ripolab/Placas-PCB/Saba-TIC 2018/Documentacion/es/guia soldadura.pptx

Taller de Soldadura Electrónica Familiar

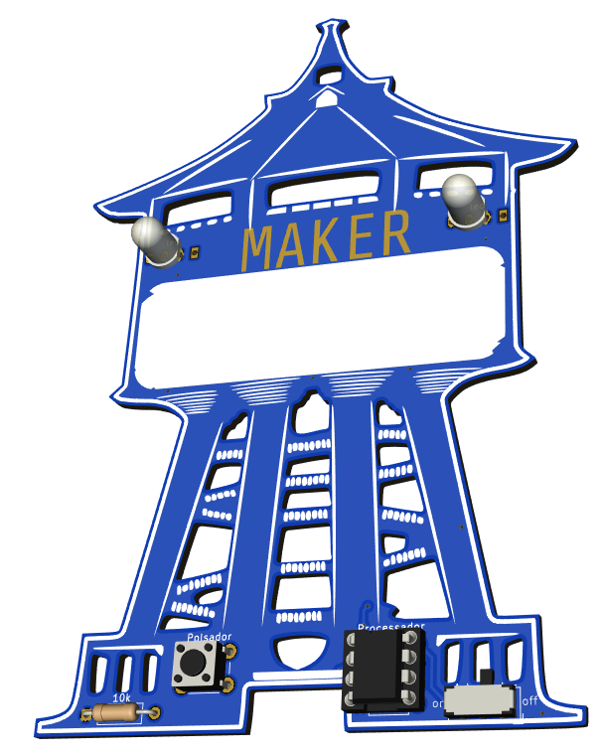
[picture p3: figure]

## Slide 2

Circuito espagueti
Un pulsador y un led

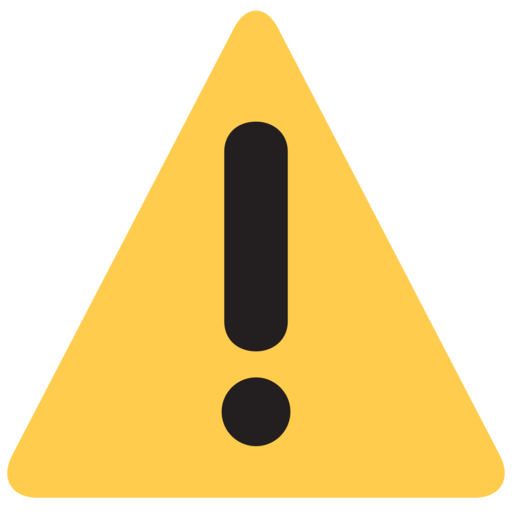
[picture p4: figure]

Rojo “+” / Negro “-”

Los leds tienen una pata “+” y “-” ¿Cual?

Mira cómo están conectados por dentro estos componentes

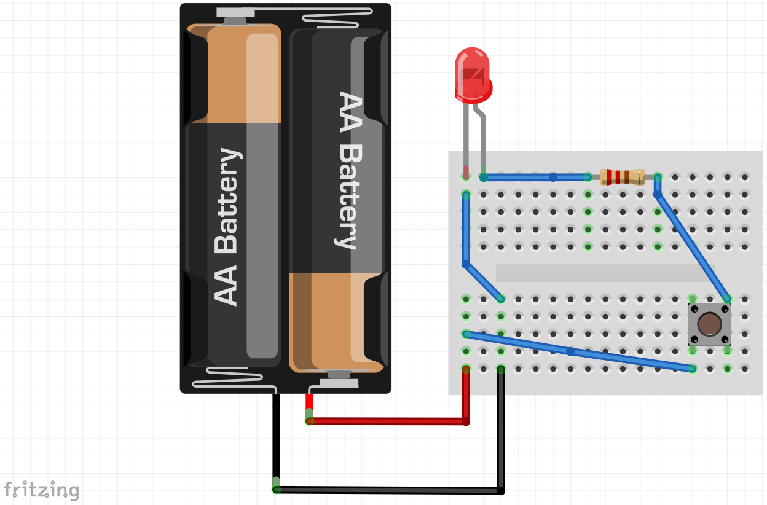
[picture p5: figure]
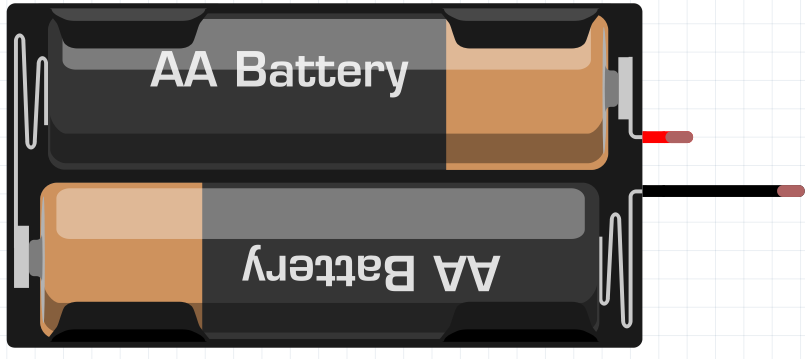
[picture p6: figure]
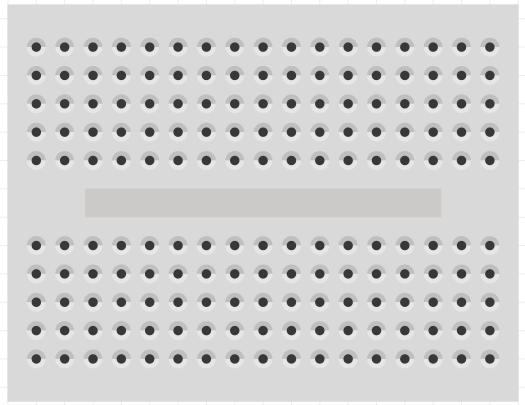
[picture p7: figure]

## Slide 3

Fabricación Digital

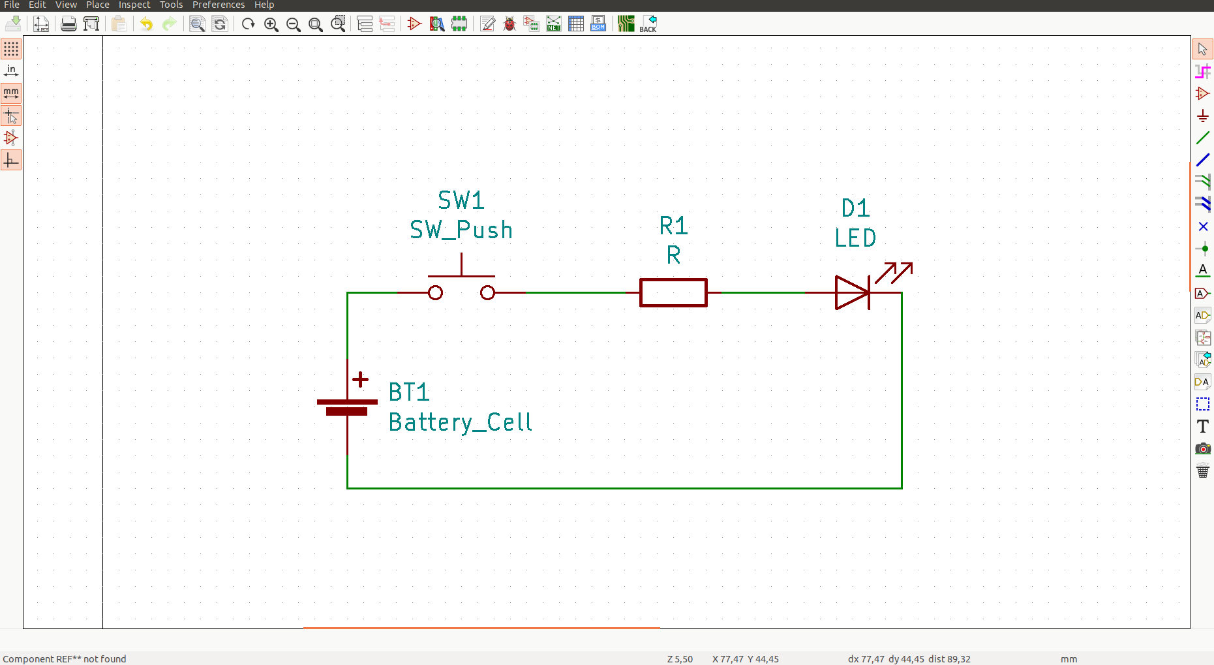
[picture p8: figure]

## Slide 4

Fabricación Digital

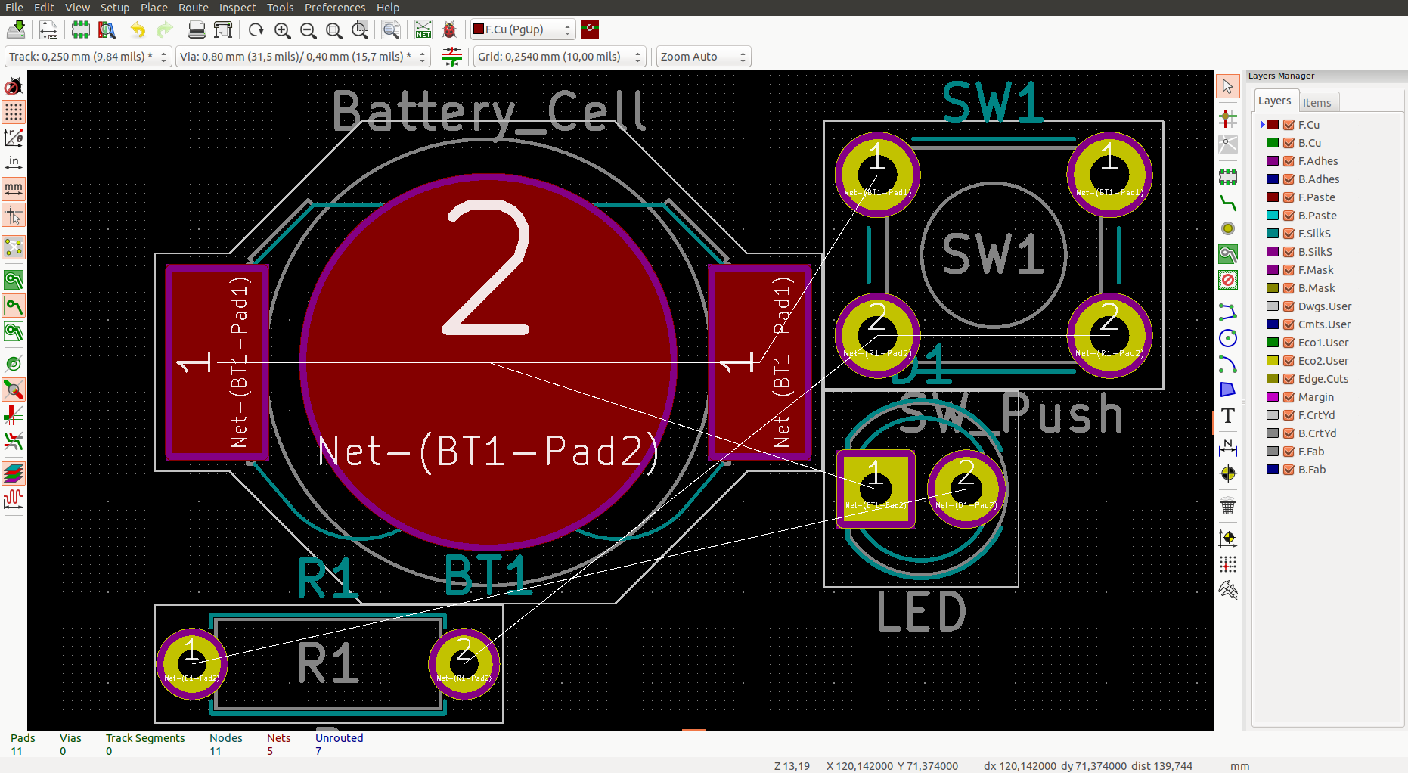
[picture p9: figure]

## Slide 5

Fabricación Digital

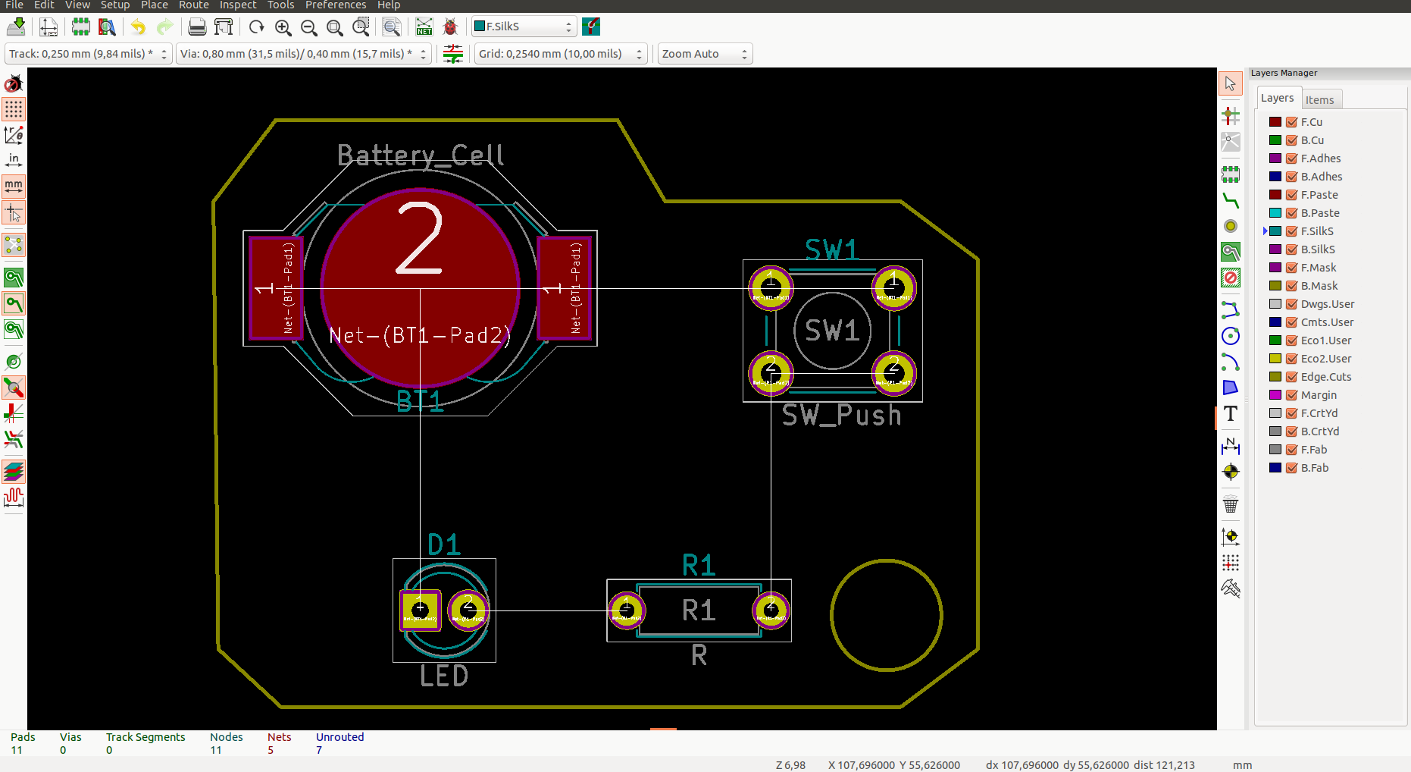
[picture p10: figure]

## Slide 6

Fabricación Digital

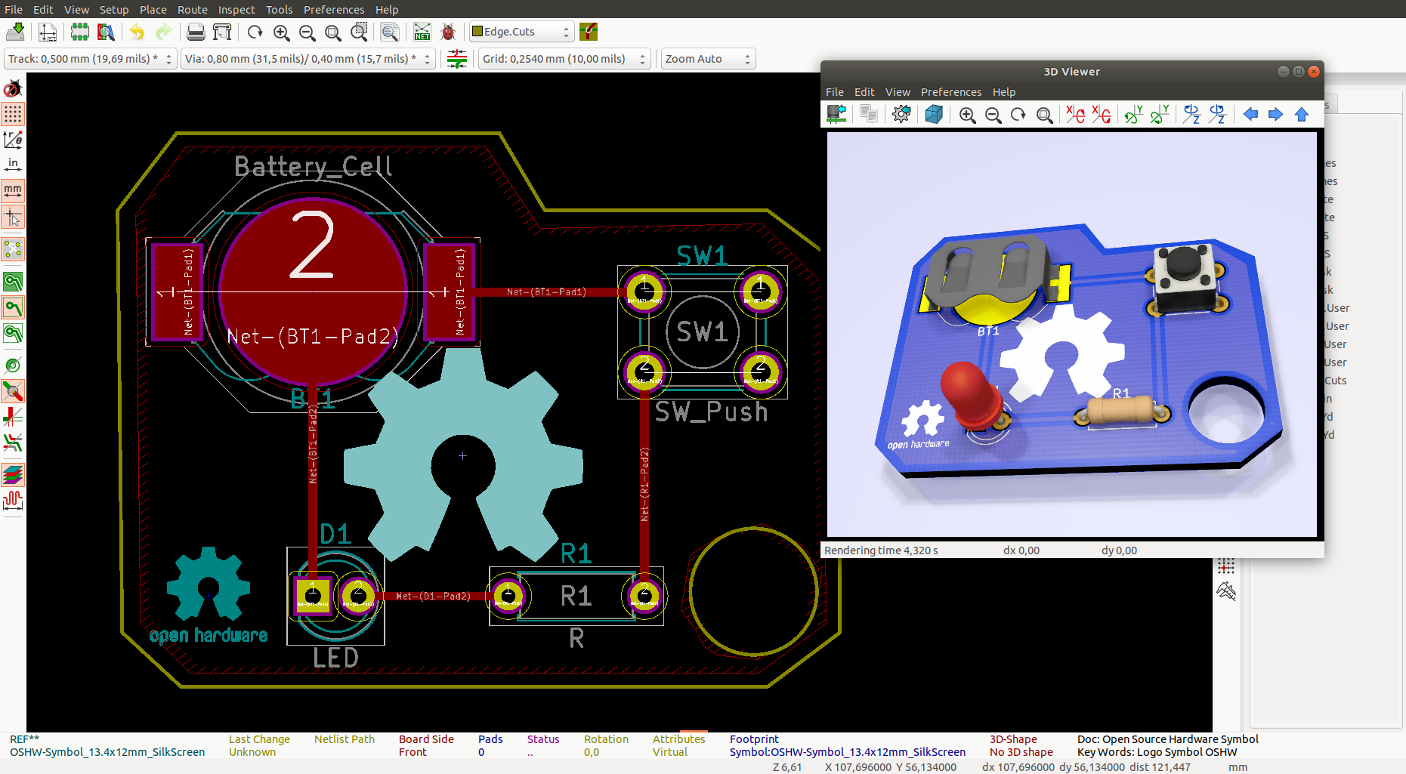
[picture p11: figure]

## Slide 7

¿Cómo utilizar el soldador?

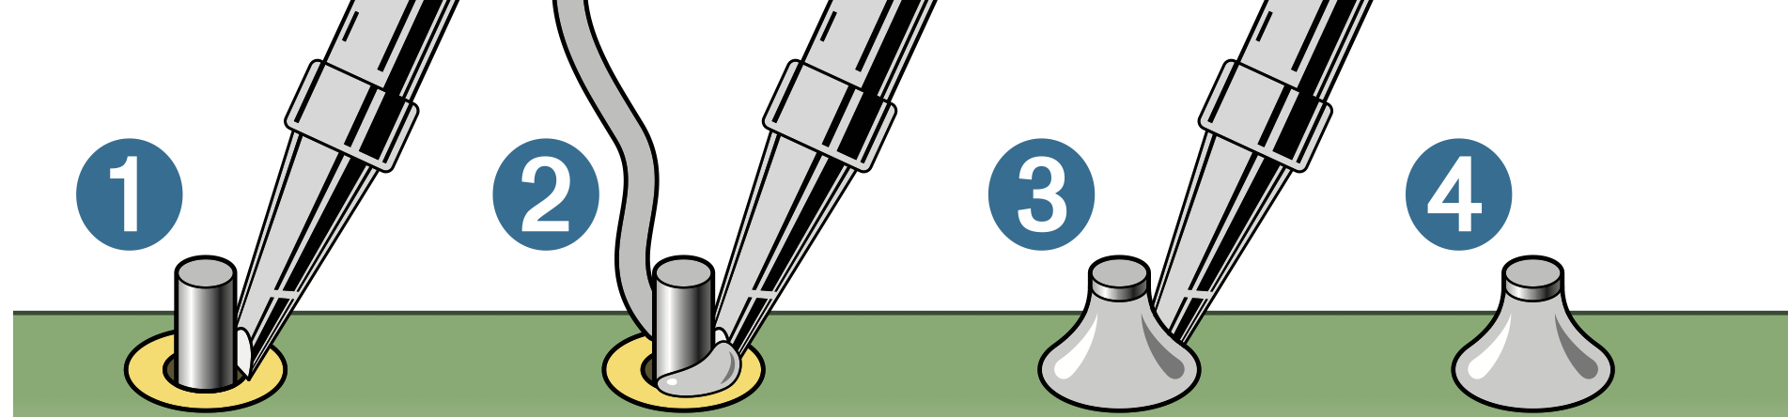
[picture p12: figure]

Calienta el componente y la base 2-3seg

Ponemos un poco de estaño

Retira el estaño y continua calentando 1-2seg

Perfecto!!!

GUIA DE SOLDADURA

Limpia simpre la punta del solddor antes de utilizarlo con un nuevo componente.

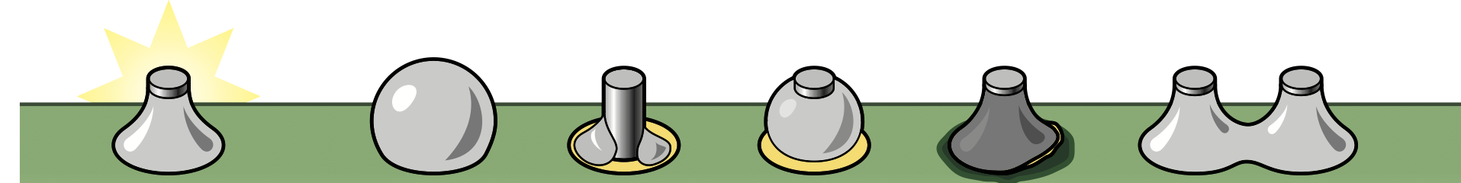
[picture p13: figure]
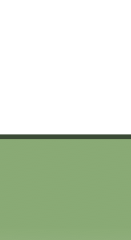
[picture p14: figure]
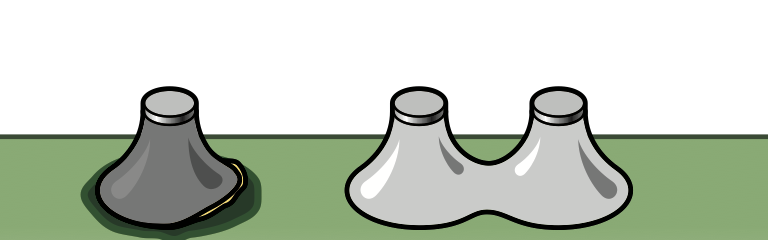
[picture p15: figure]

Cortocircuito

Perfecto

Mucho estaño

Poco estaño

Soldadura fría

Mucho calor

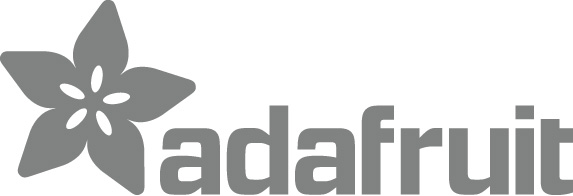
[picture p16: figure]
