ripolab/Placas-PCB/recursos/path4149.png

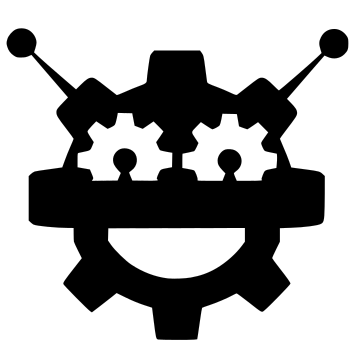
recursos/path4149.png
