ripolab/Placas-PCB/ripolab_pcb/imagenes/configuracion IDE Arduino.png

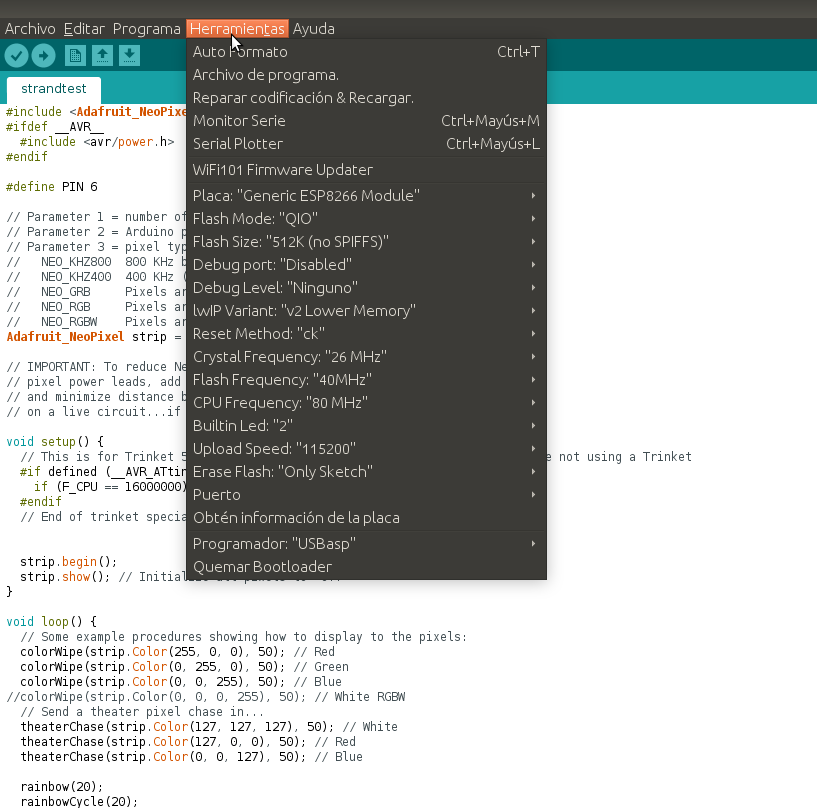
ripolab_pcb/imagenes/configuracion IDE Arduino.png
