ripolab/Placas-PCB/ripolab_pcb/imagenes/ripolab_pcb_back.jpg

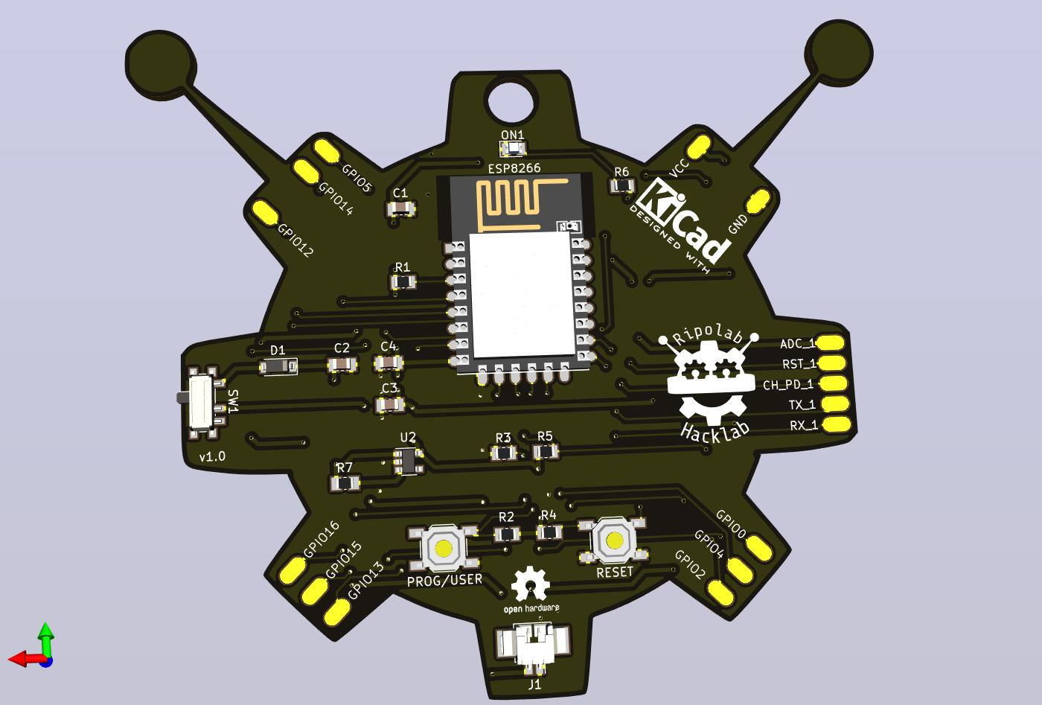
ripolab_pcb/imagenes/ripolab_pcb_back.jpg
