ripolab/Placas-PCB/ripolab_pcb/imagenes/ripolab_pcb_back_v2.jpg

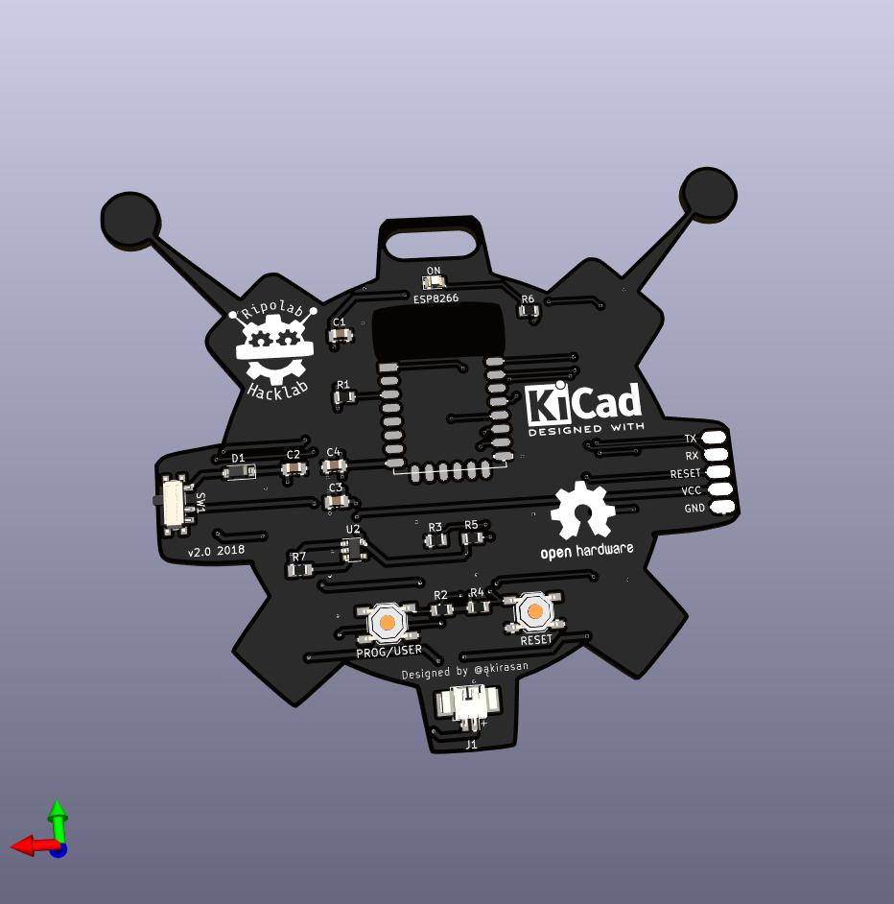
ripolab_pcb/imagenes/ripolab_pcb_back_v2.jpg
