ripolab/Placas-PCB/ripolab_pcb/imagenes/ripolab_pcb_final_back.jpg

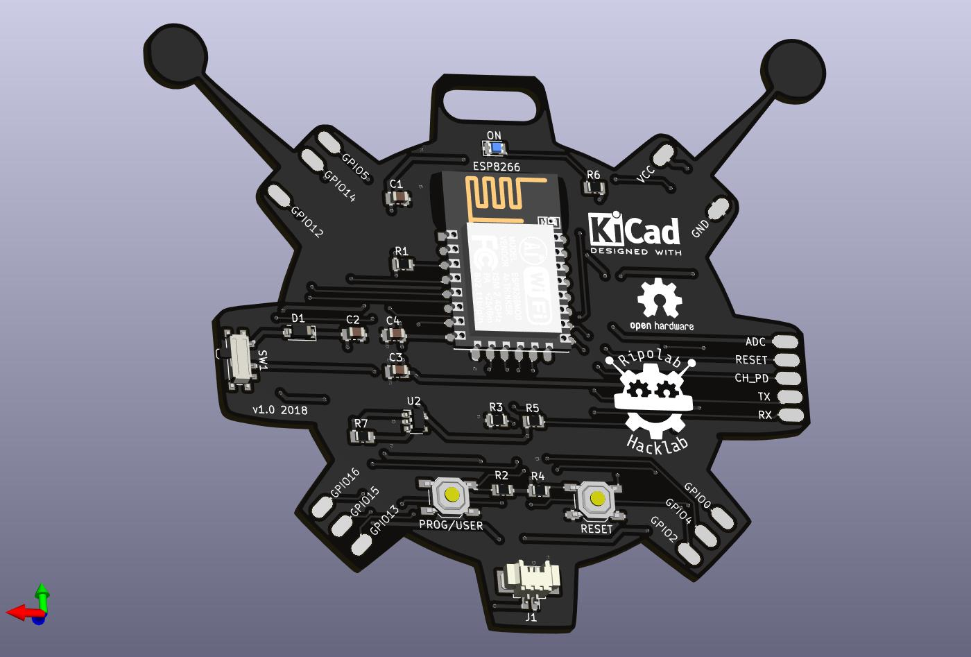
ripolab_pcb/imagenes/ripolab_pcb_final_back.jpg
