ripolab/Placas-PCB/ripolab_pcb/imagenes/ripolab_pcb_final_front.jpg

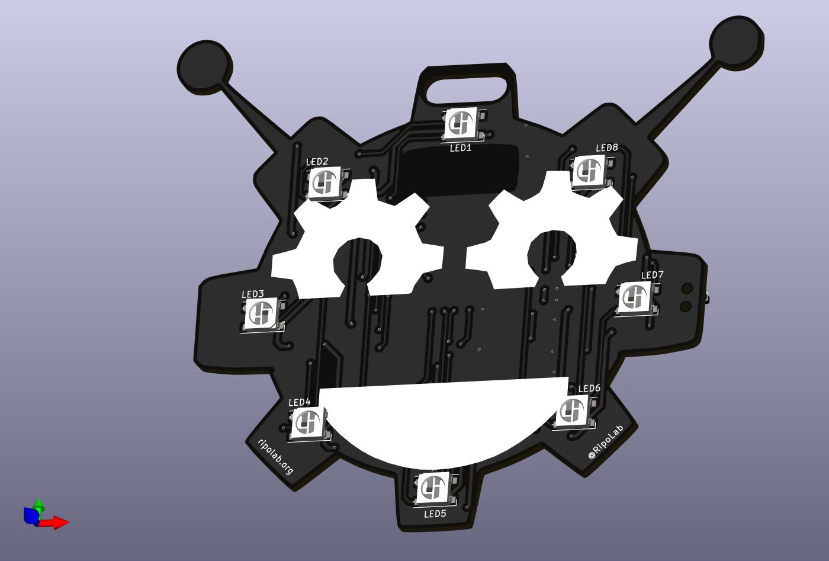
ripolab_pcb/imagenes/ripolab_pcb_final_front.jpg
