ripolab/Placas-PCB/ripolab_pcb/imagenes/ripolab_pcb_front1.jpg

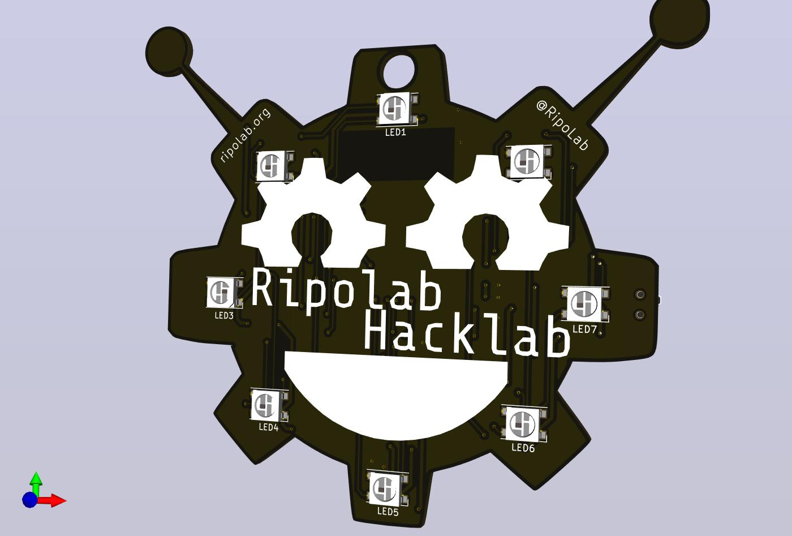
ripolab_pcb/imagenes/ripolab_pcb_front1.jpg
