ripolab/Placas-PCB/ripolab_pcb/imagenes/ripolab_pcb_front3.jpg

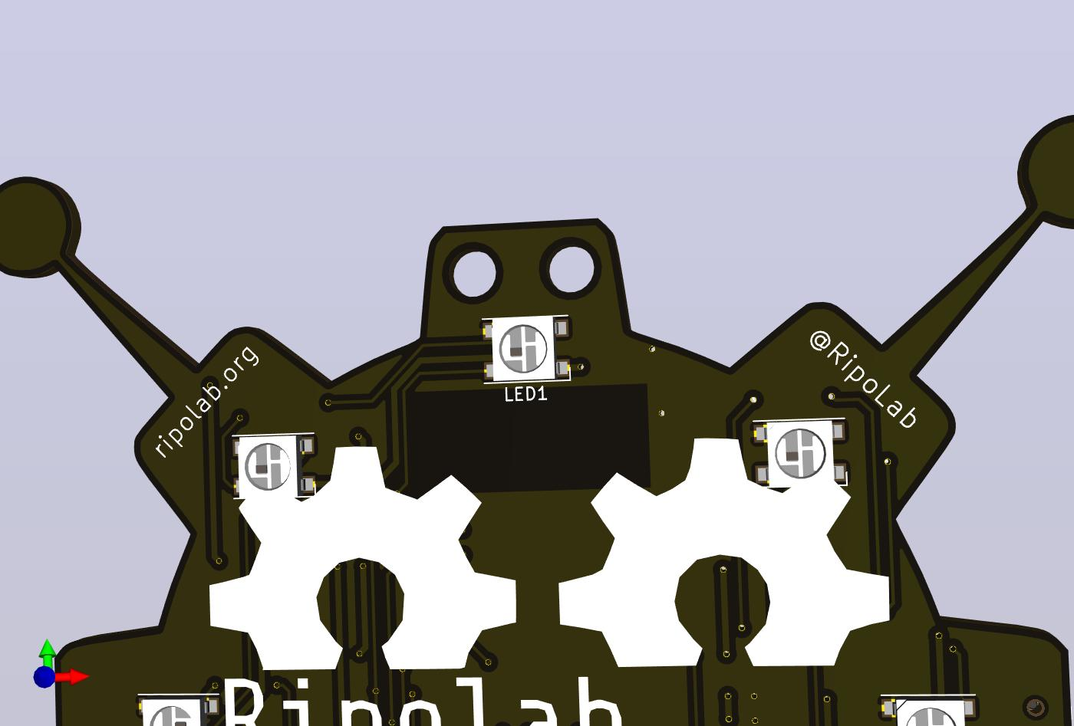
ripolab_pcb/imagenes/ripolab_pcb_front3.jpg
