ripolab/Placas-PCB/ripolab_pcb/imagenes/ripolab_pcb_front4.jpg

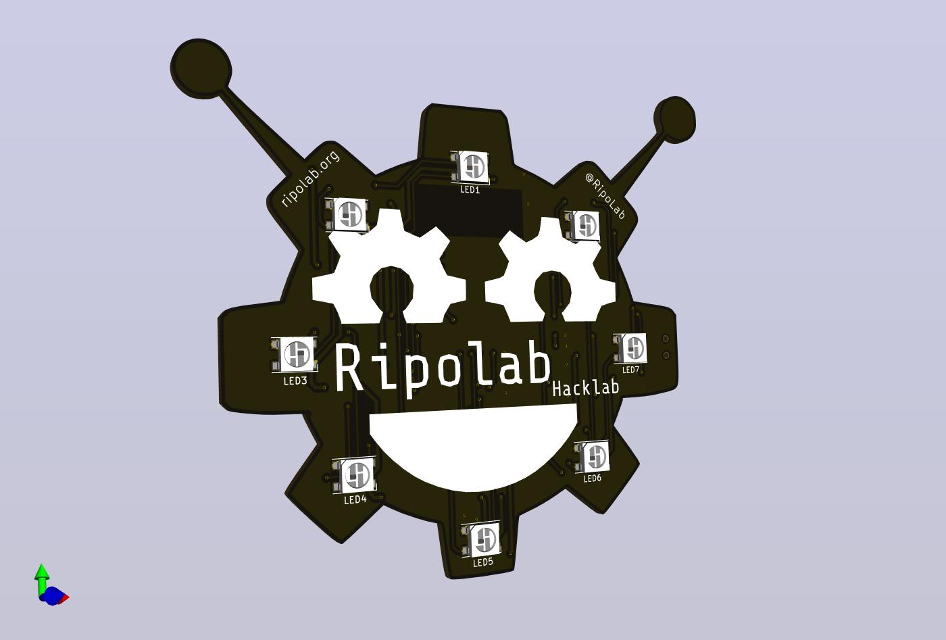
ripolab_pcb/imagenes/ripolab_pcb_front4.jpg
