ripolab/Placas-PCB/ripolab_pcb/imagenes/ripolab_pcb_front5.jpg

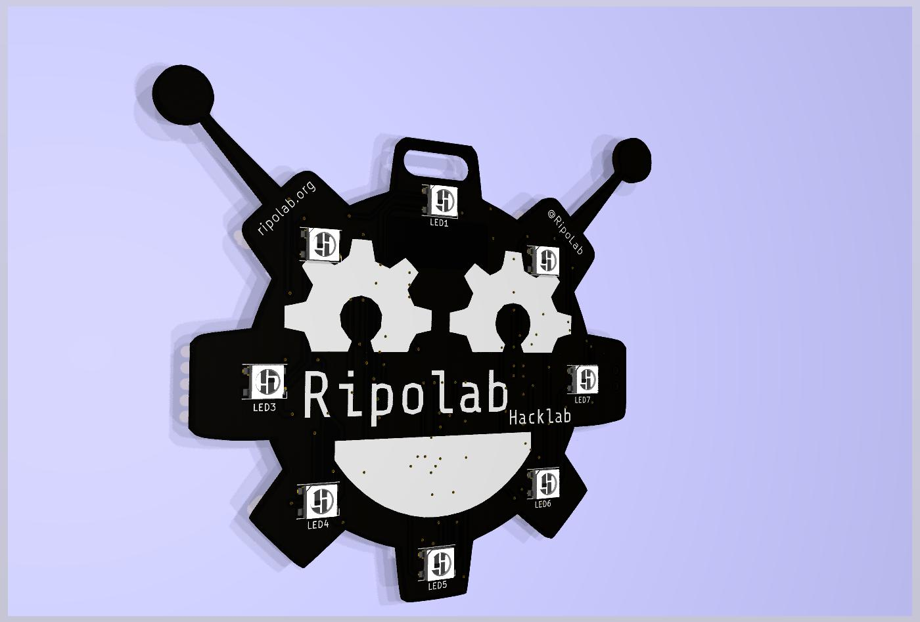
ripolab_pcb/imagenes/ripolab_pcb_front5.jpg
