ripolab/Placas-PCB/ripolab_pcb/imagenes/ripolab_pcb_front6.jpg

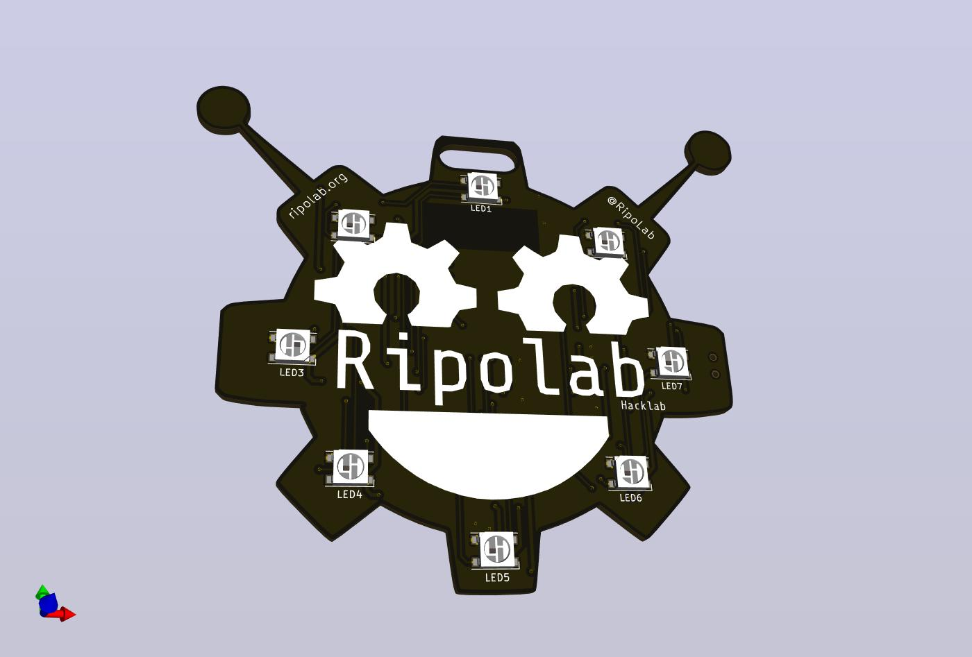
ripolab_pcb/imagenes/ripolab_pcb_front6.jpg
