ripolab/Placas-PCB/ripolab_pcb/imagenes/ripolab_pcb_front7.jpg

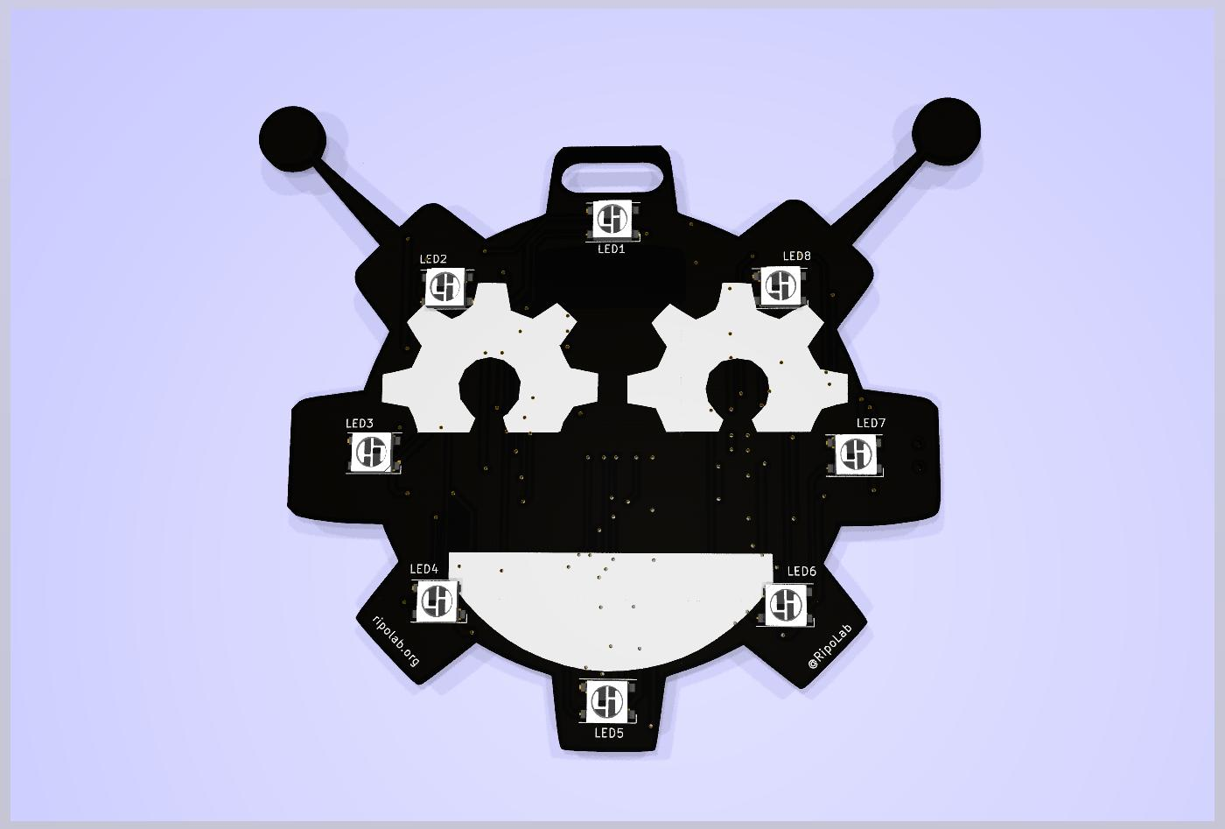
ripolab_pcb/imagenes/ripolab_pcb_front7.jpg
