ripolab/Placas-PCB/ripolab_pcb/imagenes/ripolab_pcb_front_v2.jpg

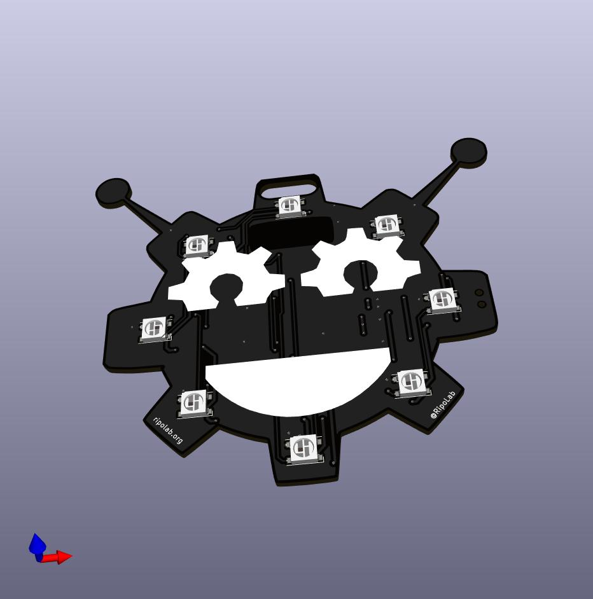
ripolab_pcb/imagenes/ripolab_pcb_front_v2.jpg
