ripolab/Placas-PCB/ripolab_protoboard/imagenes/ripolab_protroboard_v2_i2.png

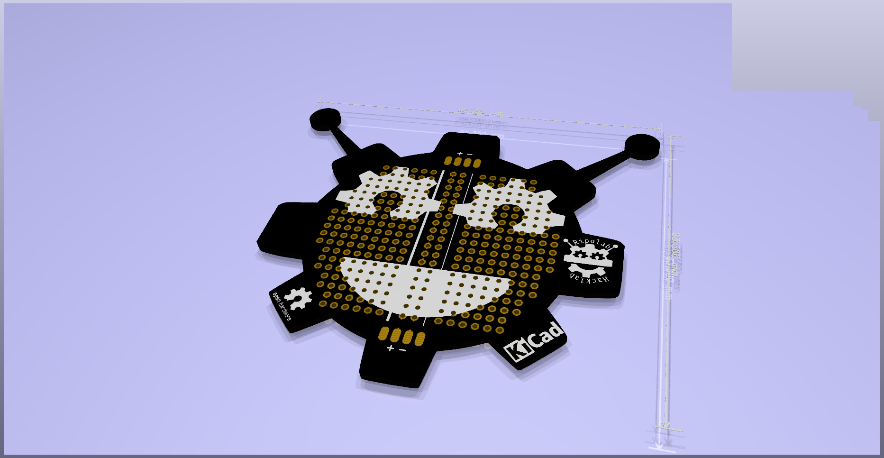
ripolab_protoboard/imagenes/ripolab_protroboard_v2_i2.png
