ripolab/Placas-PCB/ripolab_protoboard/imagenes/ripolab_protroboard_v2_i3.png

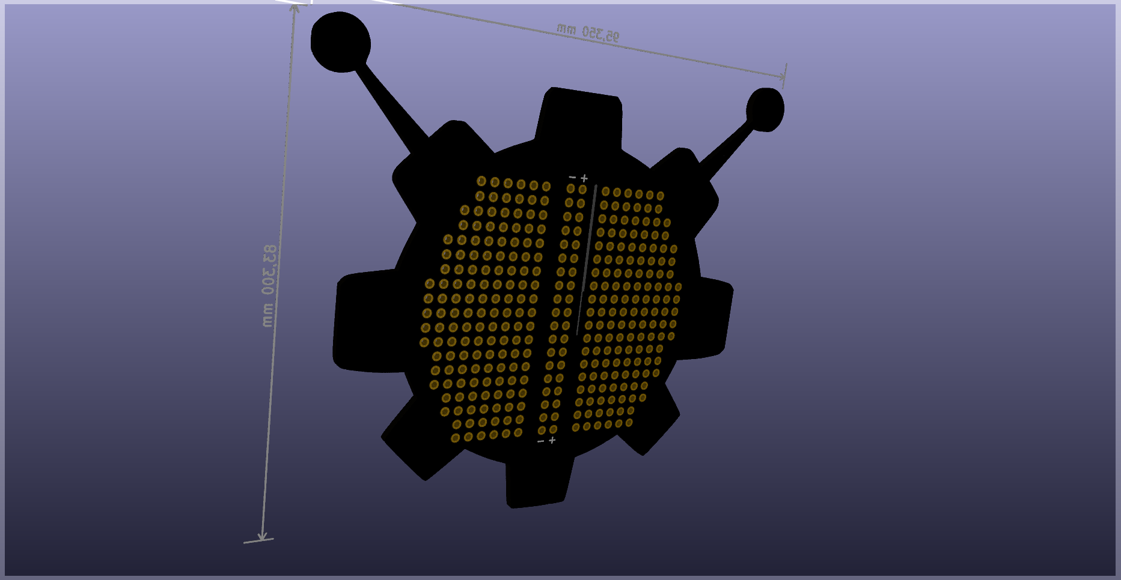
ripolab_protoboard/imagenes/ripolab_protroboard_v2_i3.png
