ripolab/Placas-PCB/ROBOTAC 19/diseño/proto1.jpg

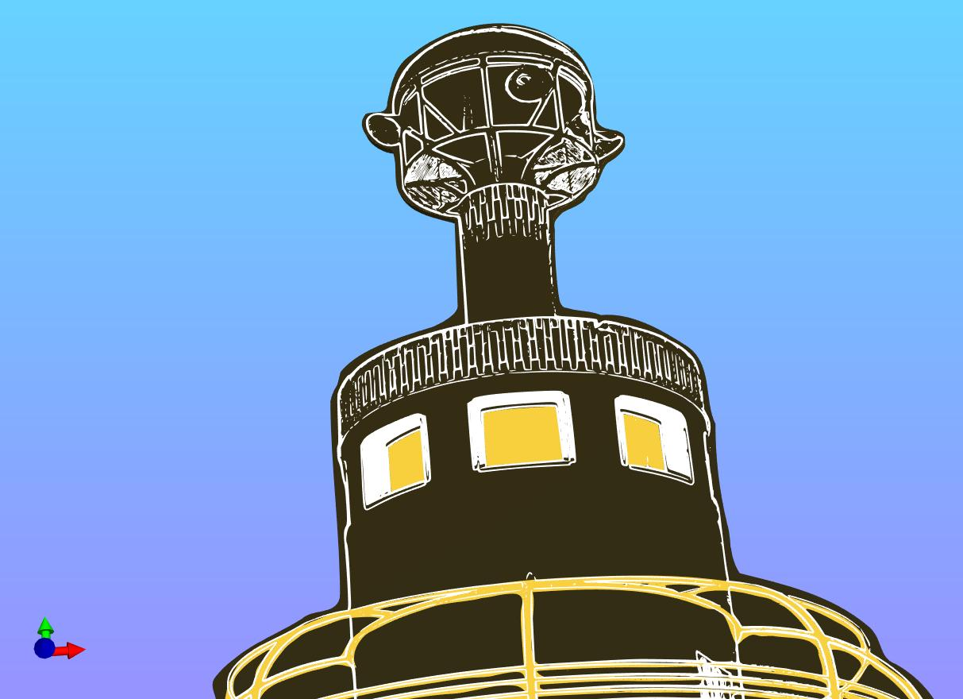
ROBOTAC 19/diseño/proto1.jpg
