ripolab/Placas-PCB/ROBOTAC 19/diseño/proto1.png

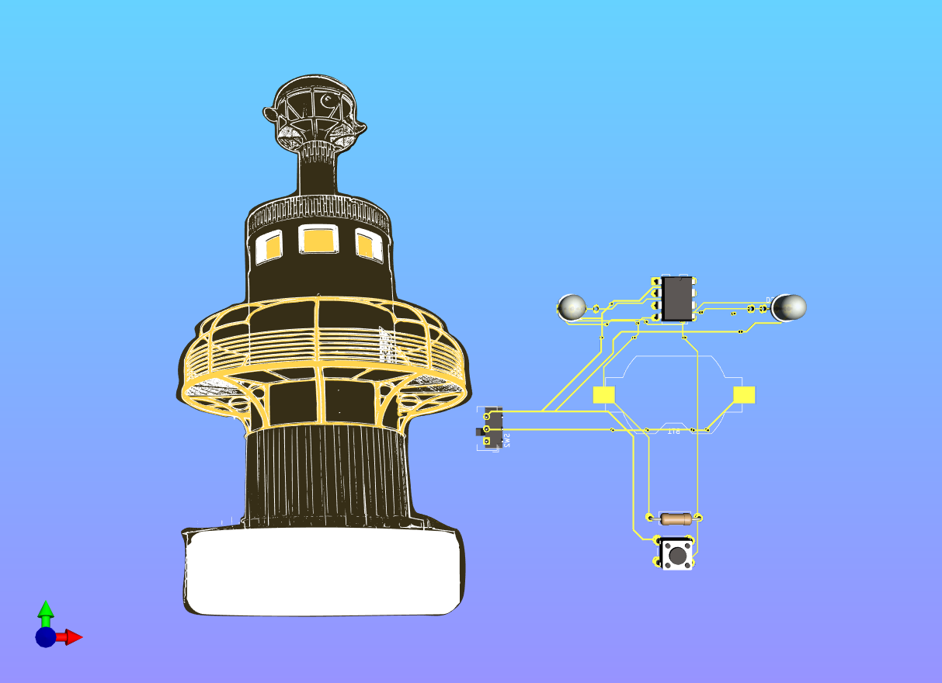
ROBOTAC 19/diseño/proto1.png
