ripolab/Placas-PCB/ROBOTAC 19/diseño/proto2.jpg

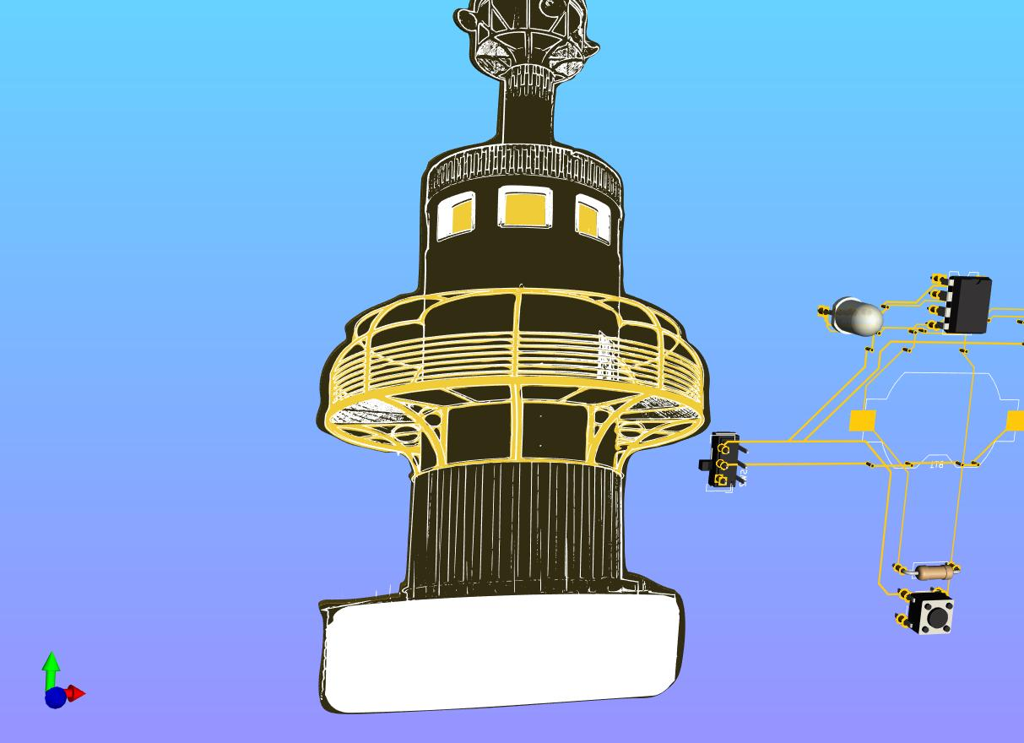
ROBOTAC 19/diseño/proto2.jpg
