ripolab/Placas-PCB/ROBOTAC 19/diseño/proto2.png

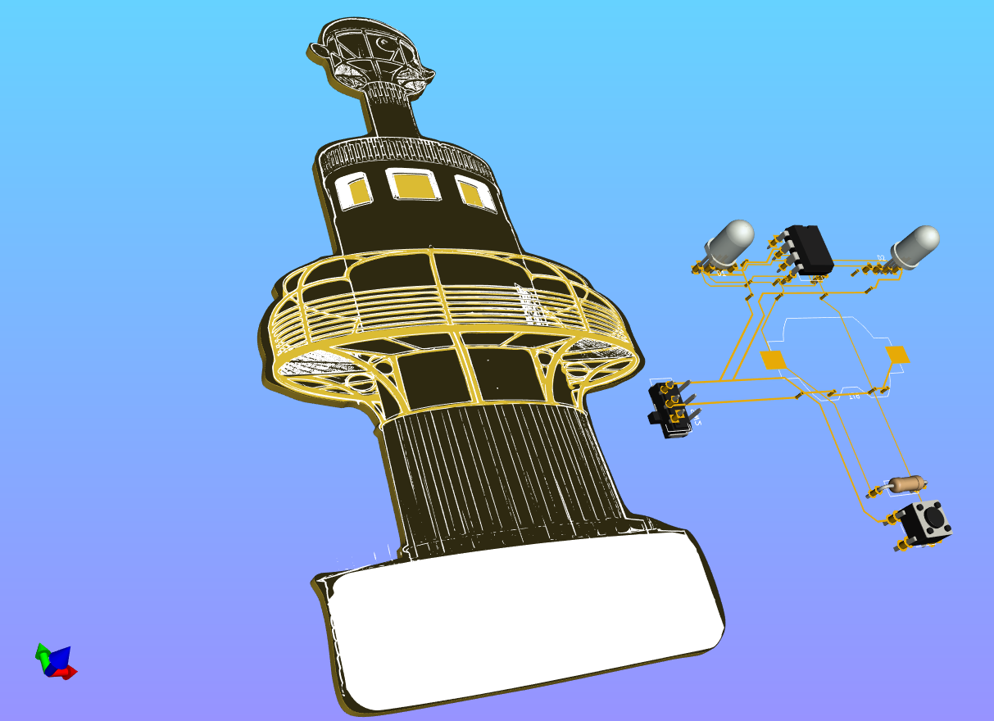
ROBOTAC 19/diseño/proto2.png
