ripolab/Placas-PCB/ROBOTAC 19/diseño/proto3.jpg

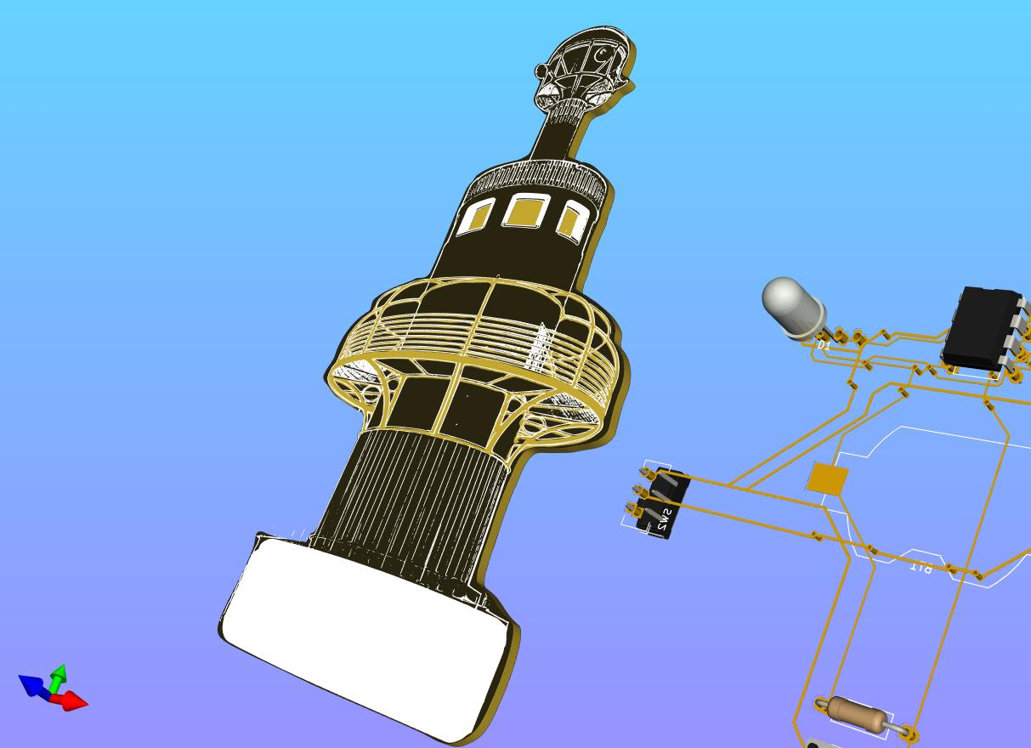
ROBOTAC 19/diseño/proto3.jpg
