ripolab/Placas-PCB/ROBOTAC 19/diseño/proto4.jpg

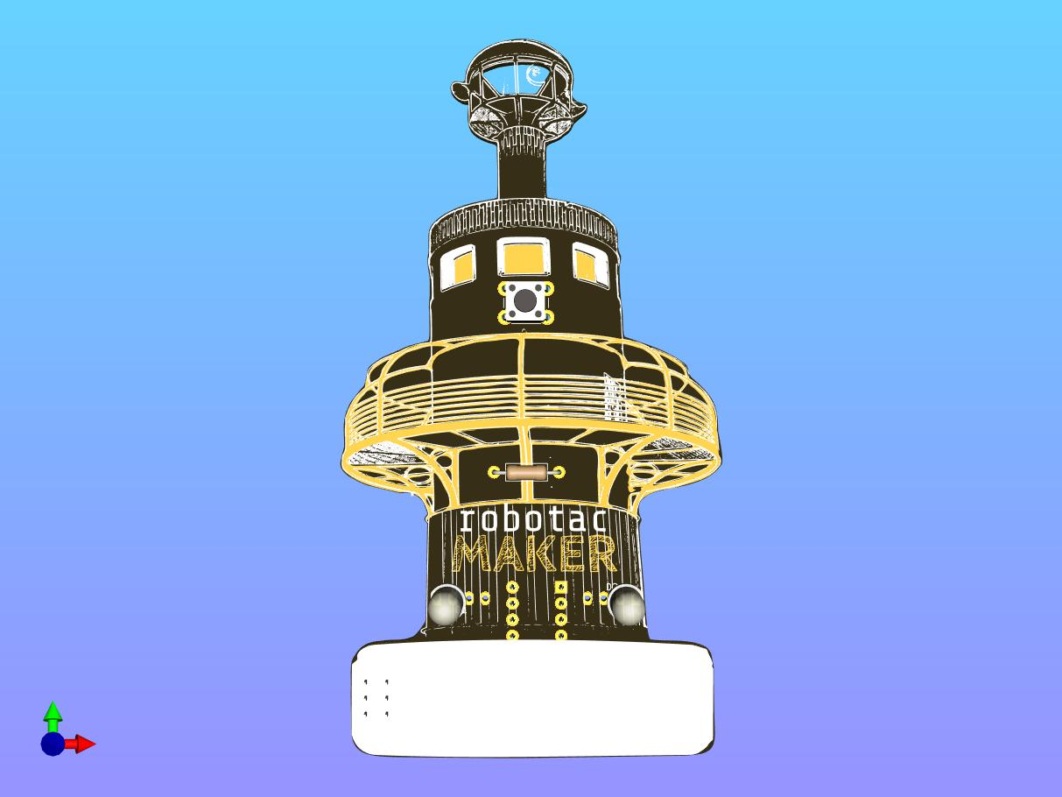
ROBOTAC 19/diseño/proto4.jpg
