ripolab/Placas-PCB/ROBOTAC 19/diseño/proto5.jpg

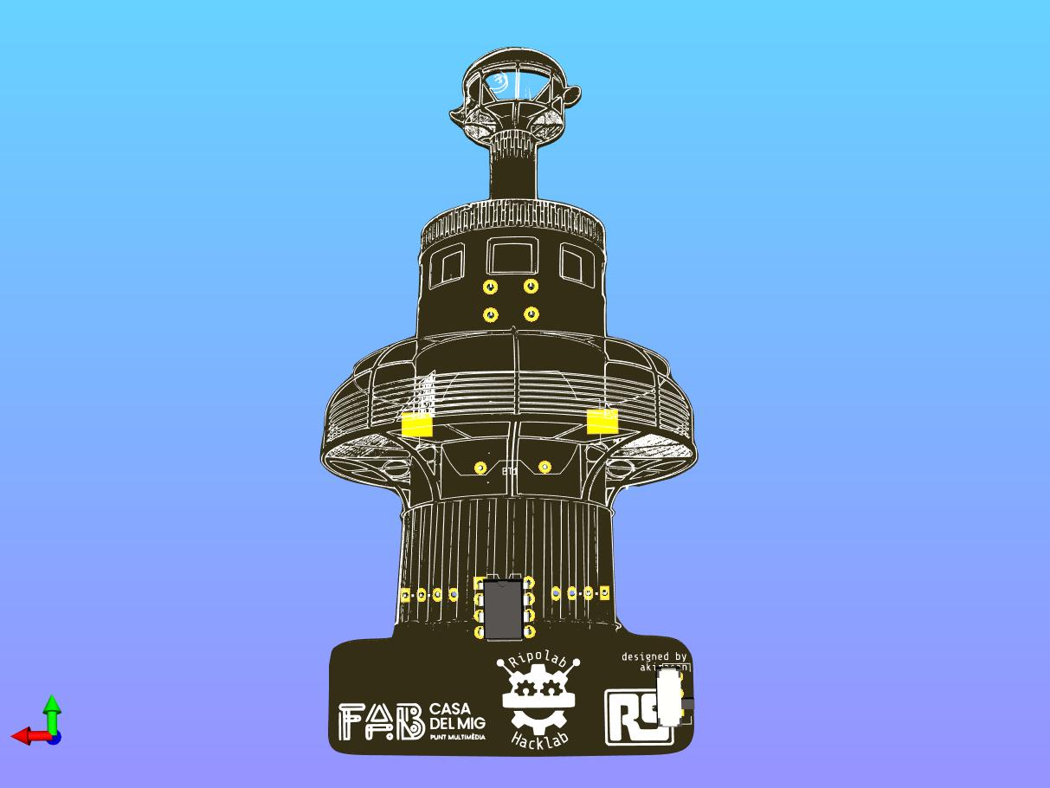
ROBOTAC 19/diseño/proto5.jpg
