ripolab/Placas-PCB/ROBOTAC 19/diseño/proto6.jpg

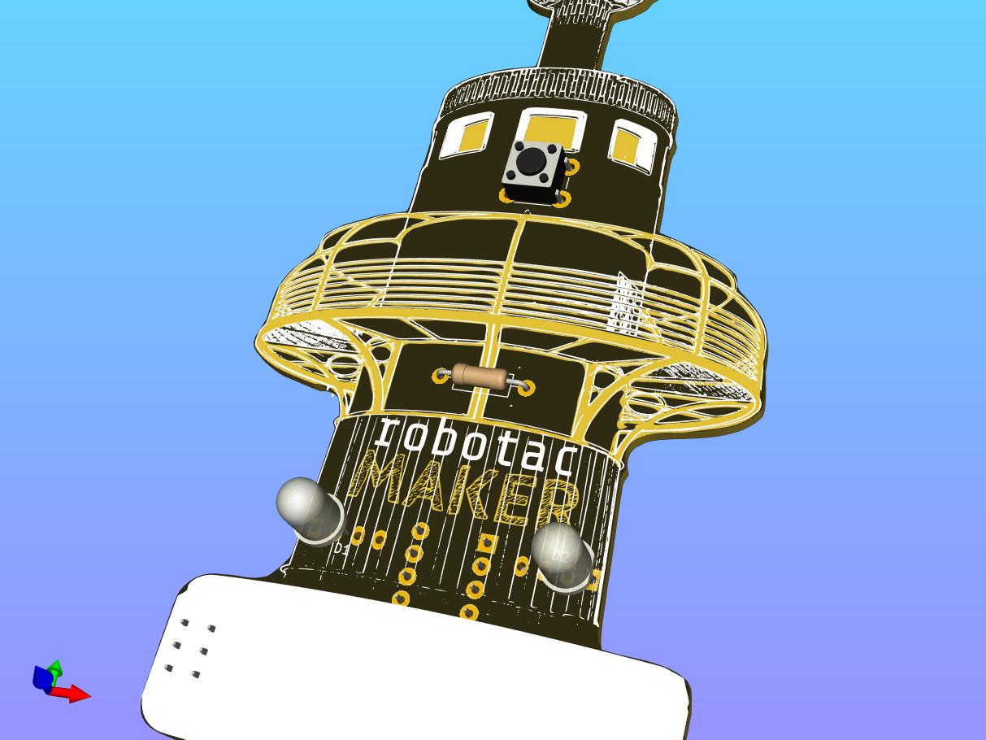
ROBOTAC 19/diseño/proto6.jpg
