ripolab/Placas-PCB/ROBOTAC 19/diseño/proto7.jpg

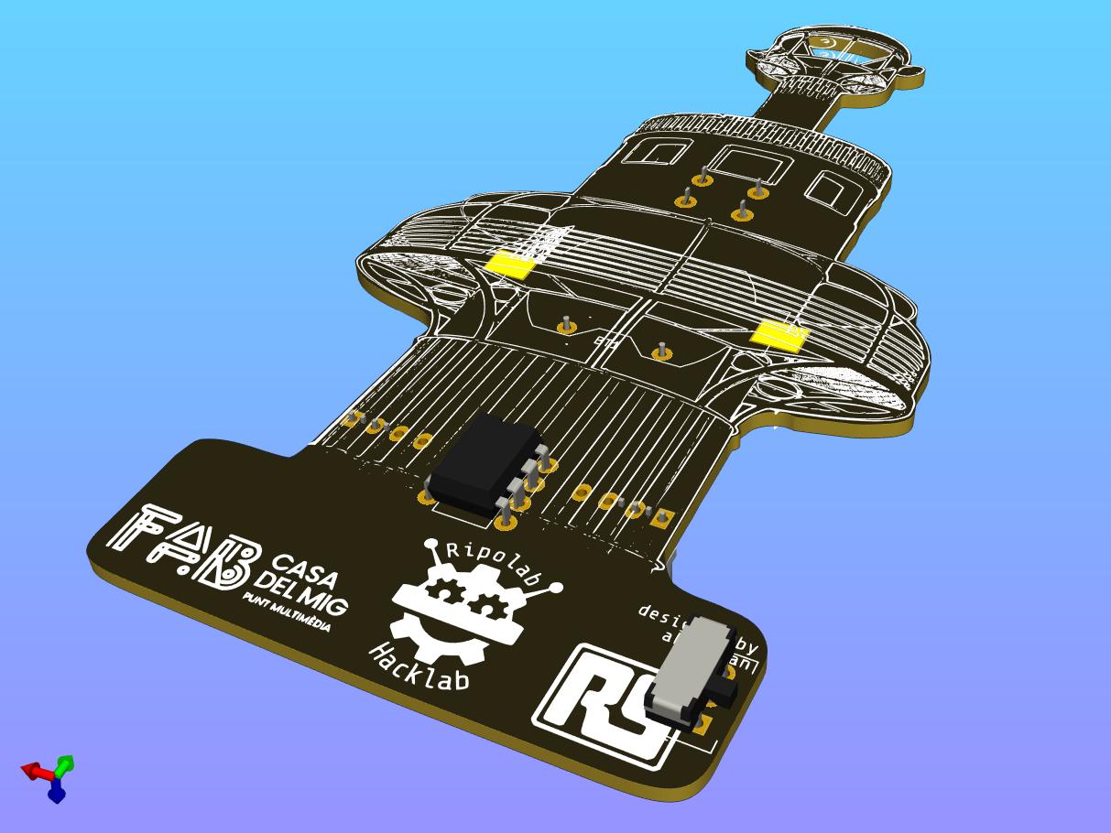
ROBOTAC 19/diseño/proto7.jpg
