ripolab/Placas-PCB/ROBOTAC 19/imagenes/86682639-vista-de-barcelona-españa-panorama-del-parc-de-l-espanya-industrial-en-día-de-verano-en-el-fondo-la-es.jpg

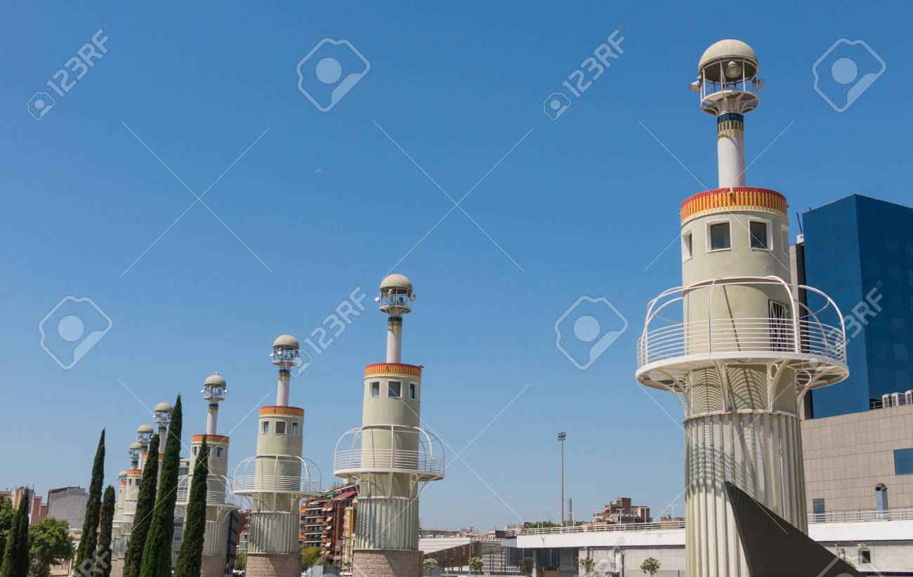
ROBOTAC 19/imagenes/86682639-vista-de-barcelona-españa-panorama-del-parc-de-l-espanya-industrial-en-día-de-verano-en-el-fondo-la-es.jpg
