ripolab/Placas-PCB/ROBOTAC 19/imagenes/espana_industrial_6.jpg

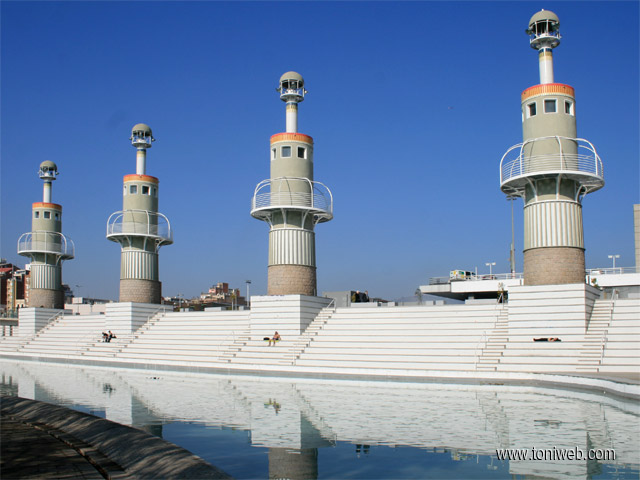
ROBOTAC 19/imagenes/espana_industrial_6.jpg
