ripolab/Placas-PCB/ROBOTAC 19/imagenes/faros-espanya-industrial.jpg

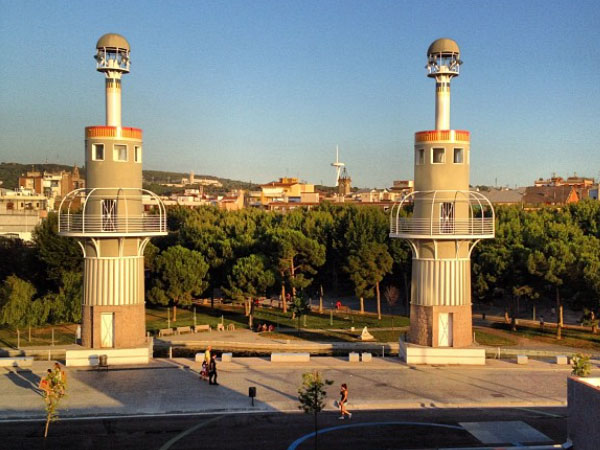
ROBOTAC 19/imagenes/faros-espanya-industrial.jpg
