ripolab/Placas-PCB/ROBOTAC 19/imagenes/p7240010.jpg

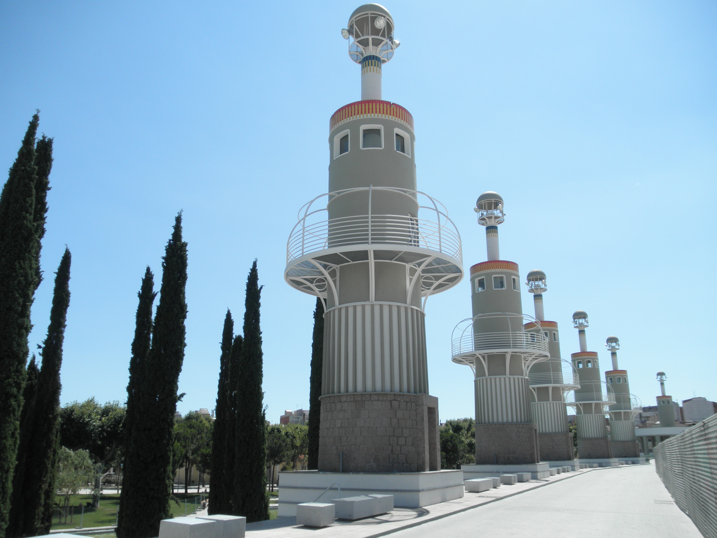
ROBOTAC 19/imagenes/p7240010.jpg
