ripolab/Placas-PCB/ROBOTAC 19/imagenes/p7240010_hierro.png

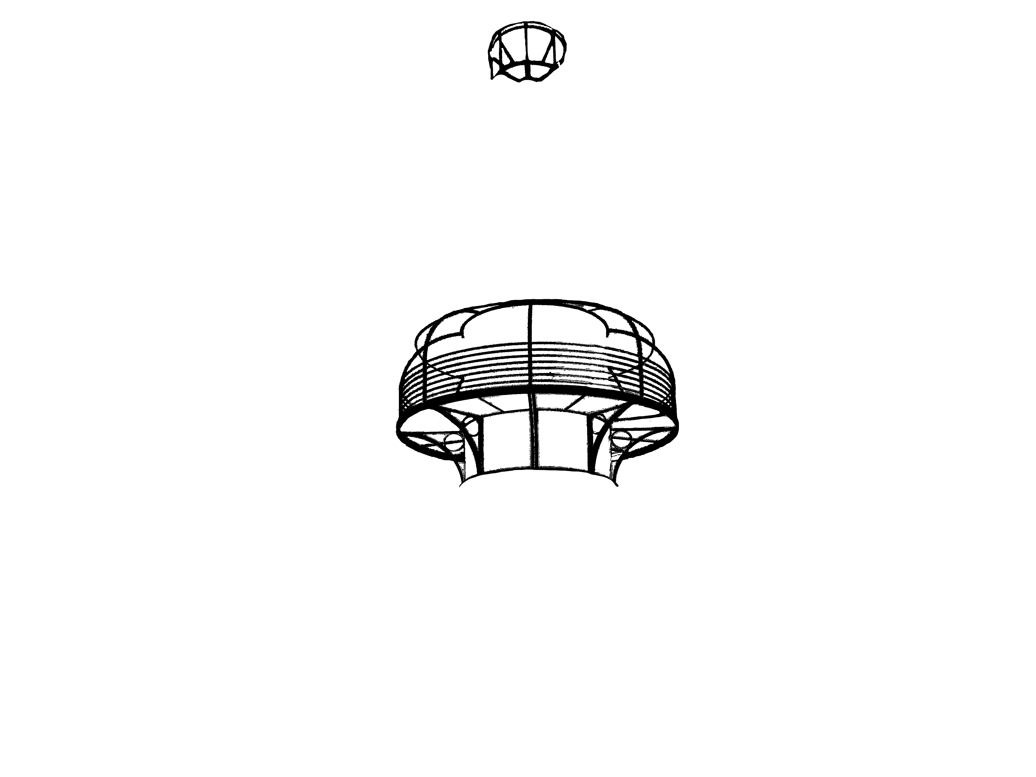
ROBOTAC 19/imagenes/p7240010_hierro.png
