ripolab/Placas-PCB/ROBOTAC 19/imagenes/recorte exterior.png

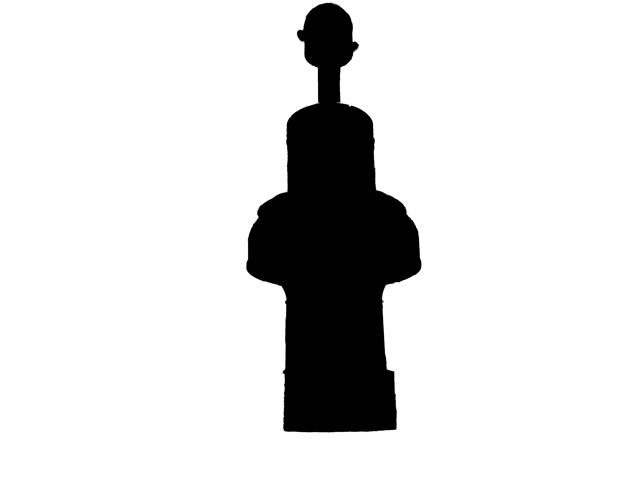
ROBOTAC 19/imagenes/recorte exterior.png
