ripolab/Placas-PCB/Saba-TIC 2018/imagenes/Saba-TIC18_1.jpg

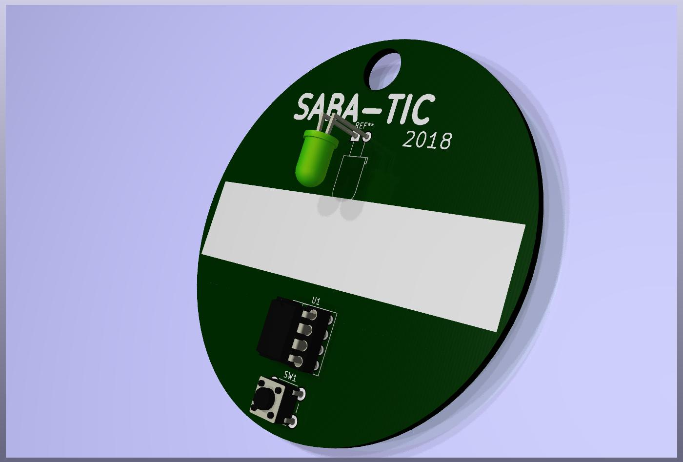
Saba-TIC 2018/imagenes/Saba-TIC18_1.jpg
