ripolab/Placas-PCB/Saba-TIC 2018/imagenes/sabatic_0_0.jpg

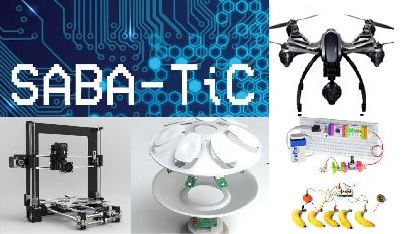
Saba-TIC 2018/imagenes/sabatic_0_0.jpg
