ripolab/Placas-PCB/Saba-TIC 2018/Saba-TIC18.png

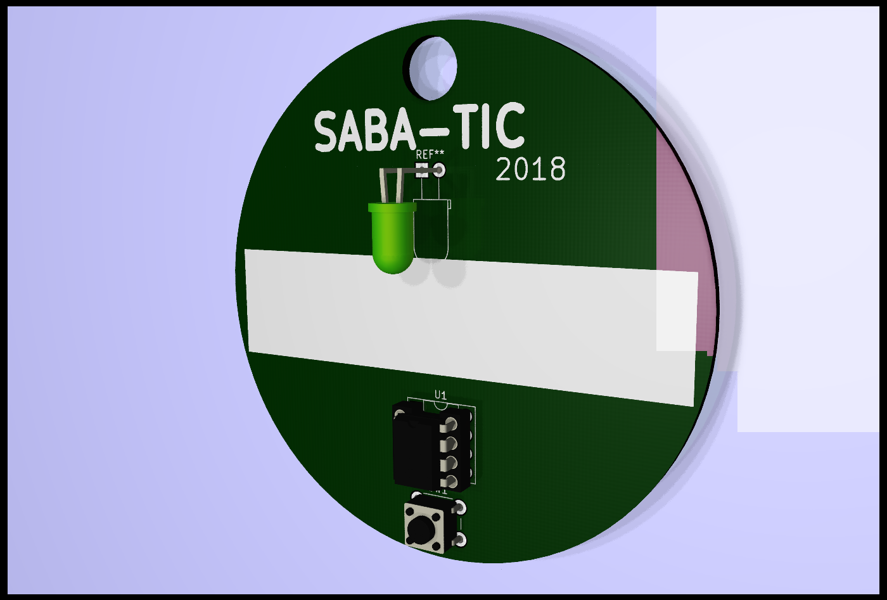
Saba-TIC 2018/Saba-TIC18.png
