ripolab/Placas-PCB/ripolab_pcb/BOM.txt

Comp            Cantidad    Nombre
U1                  1       ESP8266-12                          https://es.aliexpress.com/item/ESP8266-12-F-Remote-Serial-Port-WIFI-Transceiver-Wireless-Board-Module-ESP-12F/32802882056.html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
J1                  1       Molex Pico-blade 1.25mm             https://es.aliexpress.com/item/50sets-JST-Molex-1-25mm-Pitch-SMD-Side-Entry-2Pin-Connector-100mm-To-250mm-with-1571/32804521041.html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
SW1                 1                                           https://es.aliexpress.com/item/50-unids-mini-7-Pasadores-encendido-apagado-1p2t-SPDT-msk-12c02-interruptor-SMD-interruptor-deslizante-para/32839604589.html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
D1                  1       Diodo Schottky                      https://es.aliexpress.com/item/Xin-Yang-electr-nico-env-o-libre-0805-1N5819-S4-SOD323-B5819WS-1N5819WS-Schottky-diodo-100/32836257305.html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
C2                  1       100nF                               https://es.aliexpress.com/item/500pcs-100nF-X7R-Error-10-50V-0805-SMD-Thick-Film-Chip-Multilayer-Ceramic-Capacitor-free-shipping/32812155708.html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
R1,R2,R3,R4,R5,R7   6       10K                                 https://es.aliexpress.com/item/SMD-Resistance-0805-10K-1-1-8W-Chip-Resistors-100PCS-LOT/32518868689.html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
U2                  1       Regulador 3.3V SPX3819M5-L-3-3      https://es.aliexpress.com/item/10PCS-SPX3819-3-3-SPX3819M5-L-3-3-TR-SPX3819M5-L-3-3-SOT23-5-LDO/32703161484.html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
C3                  1       10nF                                https://es.aliexpress.com/item/Free-shipping-0805-SMD-capacitor-10nf-50V-103K-200pcs/32375924803.html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
C4,C1               2       47uF                                https://es.aliexpress.com/item/Free-shipping-0805-SMD-capacitor-47uf-16V-476M-200PCS/32376056693.html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
WS2812B             8       WS2812B                             https://es.aliexpress.com/item/WS2812B-LED-Chip-10-1000pcs-5050-RGB-SMD-Black-White-version-WS2812-Individually-Addressable-Digital-5V/32453497583.html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
R6                  1       1K                                  https://es.aliexpress.com/item/SMD-Resistance-0805-1K-1-K-ohm-1-1-8W-Chip-Resistors-100PCS-LOT/32517545847.html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
LED_ON1             1       LED SMD                             https://es.aliexpress.com/item/100-unids-LED-SMD-0805-2012-chip-naranja-LED-diodo-emisor-de-luz-20mA-DC-2/1000004795026.html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
RST,PROG            2                                           https://es.aliexpress.com/item/100PC-Lot-SMD-4-4-1-5MM-4X4X1-5MM-Tactile-Tact-Push-Button-Micro-Switch-Momentary/32623940621.html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
