ripolab/Placas-PCB/recursos/ripolab_pcb_corte_colgante.dxf

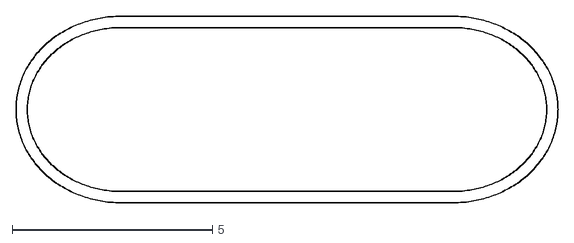
[picture p53: CAD file, 2018-04-04]
recursos/ripolab_pcb_corte_colgante.dxf
13.5 x 4.65
