ripolab/Placas-PCB/ripolab_pcb/WS2812_RGB_LED_updated.stp

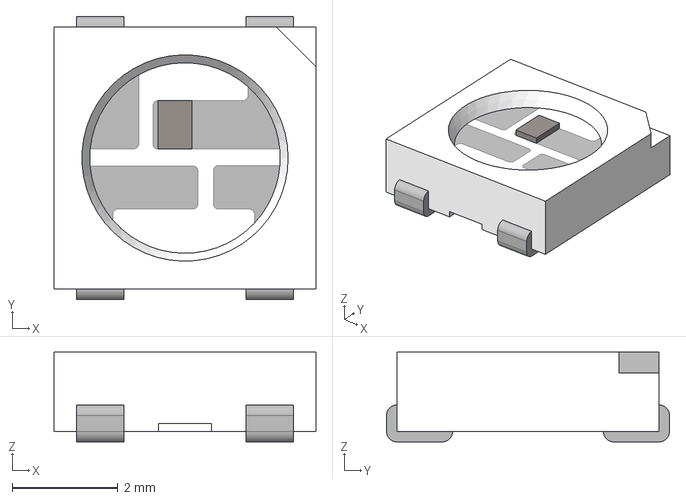
[picture p54: CAD file, 2018-04-04]
ripolab_pcb/WS2812_RGB_LED_updated.stp
4.95 x 5.35 x 1.70 mm
