ripolab/Placas-PCB/ripolab_pcb_kids/ripolab_pcb_corte.dxf

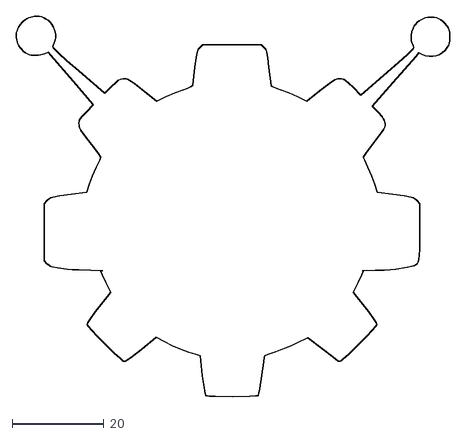
[picture p55: CAD file, 2018-04-04]
ripolab_pcb_kids/ripolab_pcb_corte.dxf
94.7 x 83.2
