ripolab/Placas-PCB/ROBOTAC 19/Piezas 3D/clip_badge_pieza2.stl

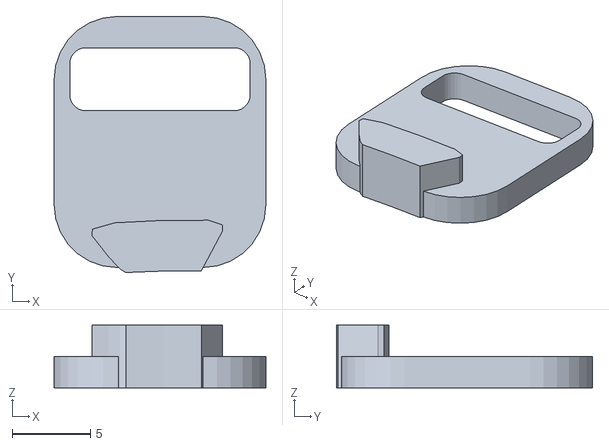
[picture p56: CAD file, 2019-04-06]
ROBOTAC 19/Piezas 3D/clip_badge_pieza2.stl
13.5 x 16.3 x 4.00
