ripolab/Placas-PCB/ROBOTAC 19/shapes3D/Vertical slide switch SS-12D00G3 High Knob 3mm SPDT v2.step

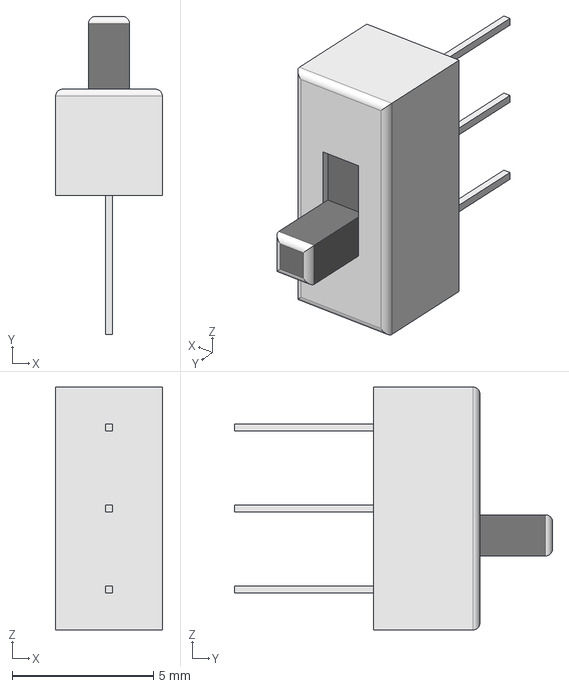
[picture p57: CAD file, 2019-04-06]
ROBOTAC 19/shapes3D/Vertical slide switch SS-12D00G3 High Knob 3mm SPDT v2.step
3.77 x 11.2 x 8.59 mm
