ripolab/Placas-PCB/Saba-TIC 2018/Diseños 3D/soporte_soldador_v3.stl

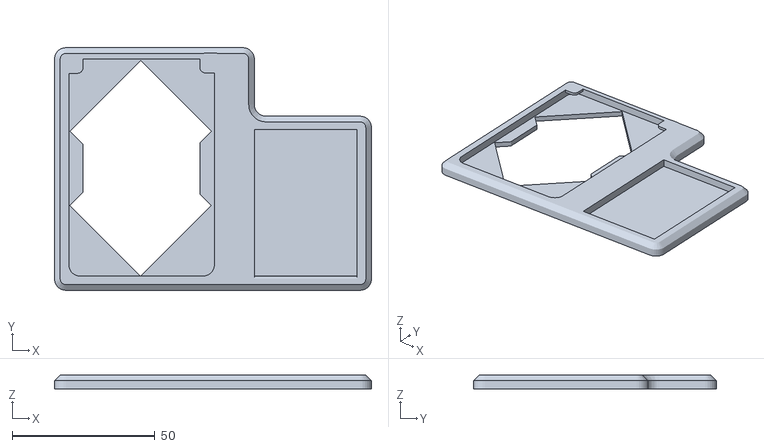
[picture p58: CAD file, 2018-09-09]
Saba-TIC 2018/Diseños 3D/soporte_soldador_v3.stl
111.0 x 85.0 x 5.00
