ripolab/Placas-PCB/ripolab_pcb/Tactile_SMD_5x5mm.STEP

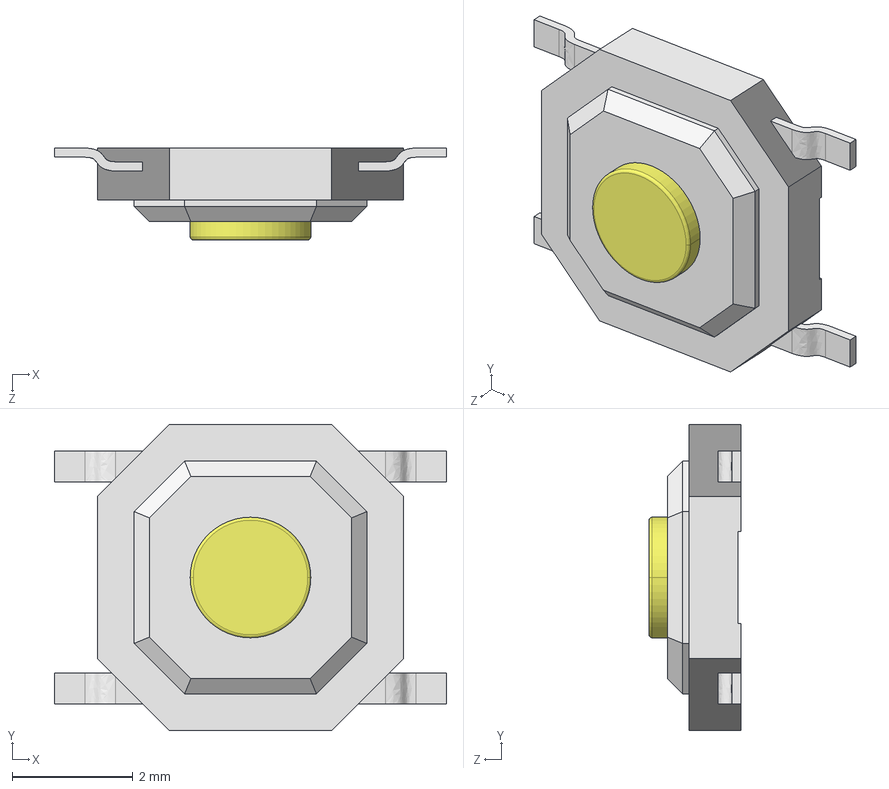
[picture p59: CAD file, 2018-04-04]
ripolab_pcb/Tactile_SMD_5x5mm.STEP
6.50 x 5.08 x 1.52 mm
