ripolab/Placas-PCB/ROBOTAC 19/diseño/corte exterior.dxf

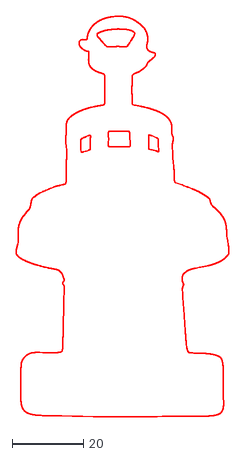
[picture p60: CAD file, 2019-04-06]
ROBOTAC 19/diseño/corte exterior.dxf
59.8 x 112.5
