ripolab/Placas-PCB/ROBOTAC 19/Piezas 3D/clip_cinta.fcstd

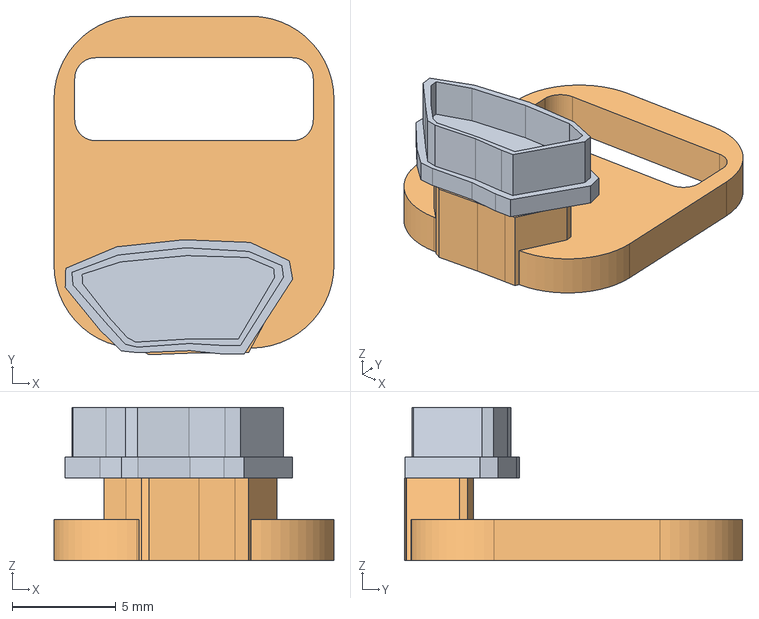
[picture p61: CAD file, 2019-04-06]
ROBOTAC 19/Piezas 3D/clip_cinta.fcstd
13.5 x 16.3 x 7.40 mm
