ripolab/Placas-PCB/ROBOTAC 19/shapes3D/CR2032 holder.step

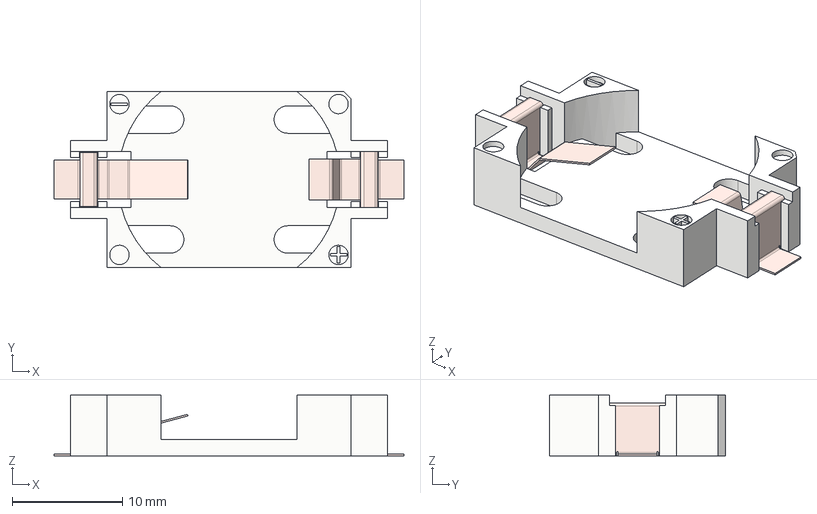
[picture p62: CAD file, 2019-04-06]
ROBOTAC 19/shapes3D/CR2032 holder.step
31.8 x 16.0 x 5.50 mm
base
connector_plus
connector_minus
