ripolab/Placas-PCB/Saba-TIC 2018/Diseños 3D/bobina_estaño.stl

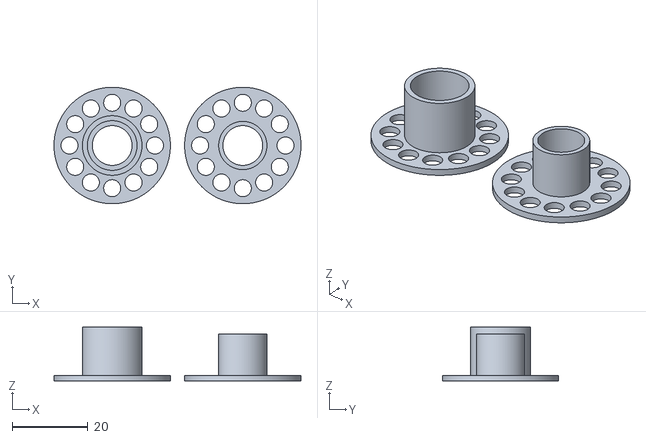
[picture p63: CAD file, 2018-09-09]
Saba-TIC 2018/Diseños 3D/bobina_estaño.stl
65.2 x 30.7 x 14.2
