ripolab/Placas-PCB/ripolab_pcb/AB2_PB_MOM_5.2MM_SMD.stl

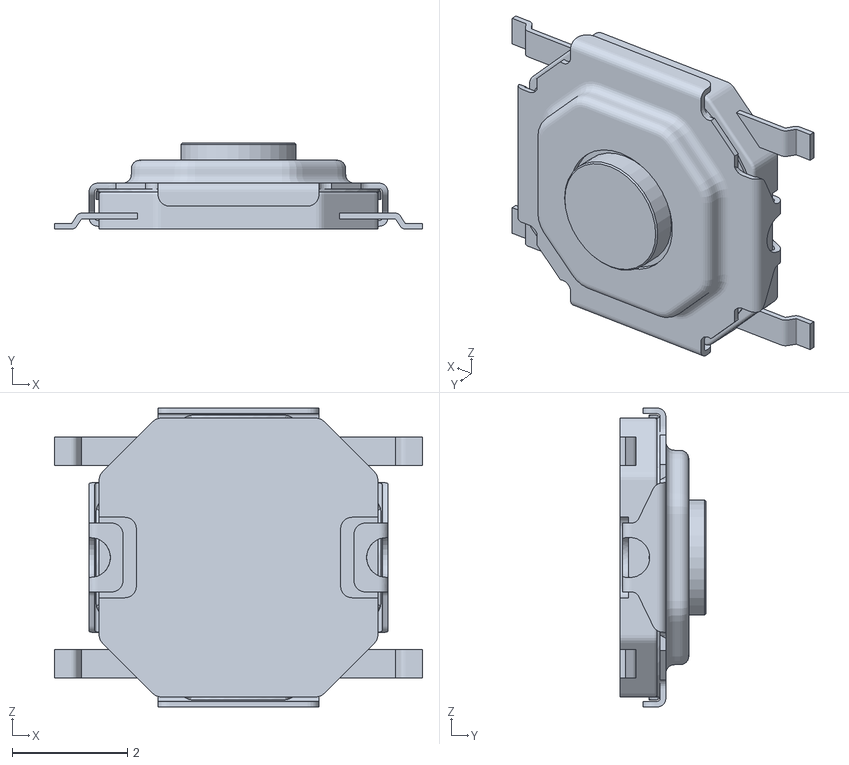
[picture p64: CAD file, 2018-04-04]
ripolab_pcb/AB2_PB_MOM_5.2MM_SMD.stl
6.40 x 1.50 x 5.20
