ripolab/Placas-PCB/ROBOTAC 19/Piezas 3D/clip_badge_pieza1.stl

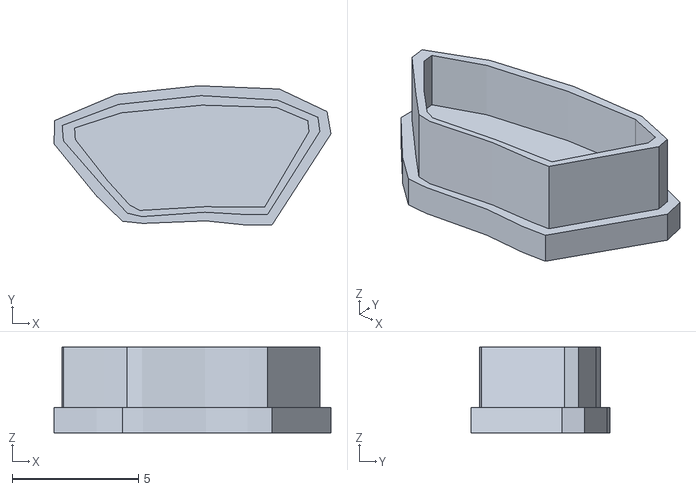
[picture p65: CAD file, 2019-04-06]
ROBOTAC 19/Piezas 3D/clip_badge_pieza1.stl
11.0 x 5.52 x 3.40
