ripolab/Placas-PCB/Saba-TIC 2018/Diseños 3D/soporte_3hands_v4.stl

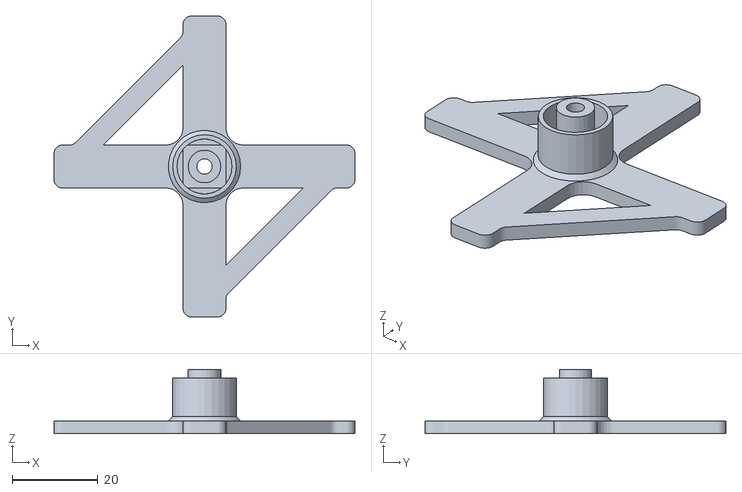
[picture p66: CAD file, 2018-09-09]
Saba-TIC 2018/Diseños 3D/soporte_3hands_v4.stl
70.0 x 70.0 x 15.0
