ripolab/Placas-PCB/(list of files, cad)

Other CAD files:
ROBOTAC 19/diseño/rote exterior.dxf
ripolab_pcb/Tactile_SMD_5x5mm.SLDPRT
