ripolab/Placas-PCB/ROBOTAC 19/Documentacion/imagenes manual/IMG_20190327_193451.jpg

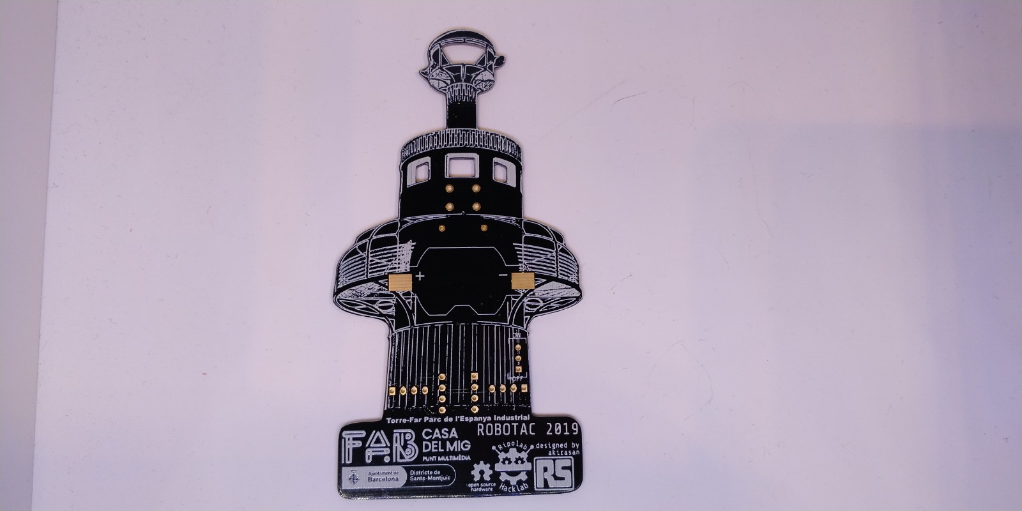
ROBOTAC 19/Documentacion/imagenes manual/IMG_20190327_193451.jpg
