ripolab/Placas-PCB/ROBOTAC 19/Documentacion/imagenes manual/IMG_20190327_200442.jpg

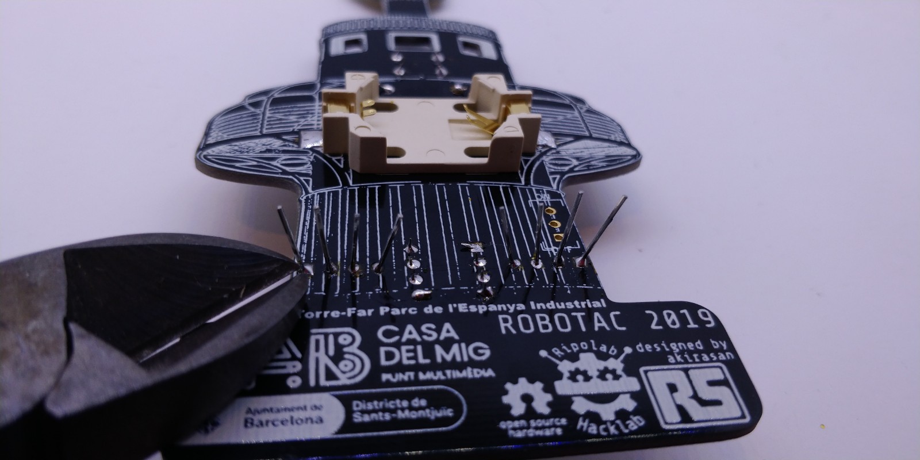
ROBOTAC 19/Documentacion/imagenes manual/IMG_20190327_200442.jpg
