ripolab/Placas-PCB/Saba-TIC 2018/documentacion/all_2_PCB.pdf

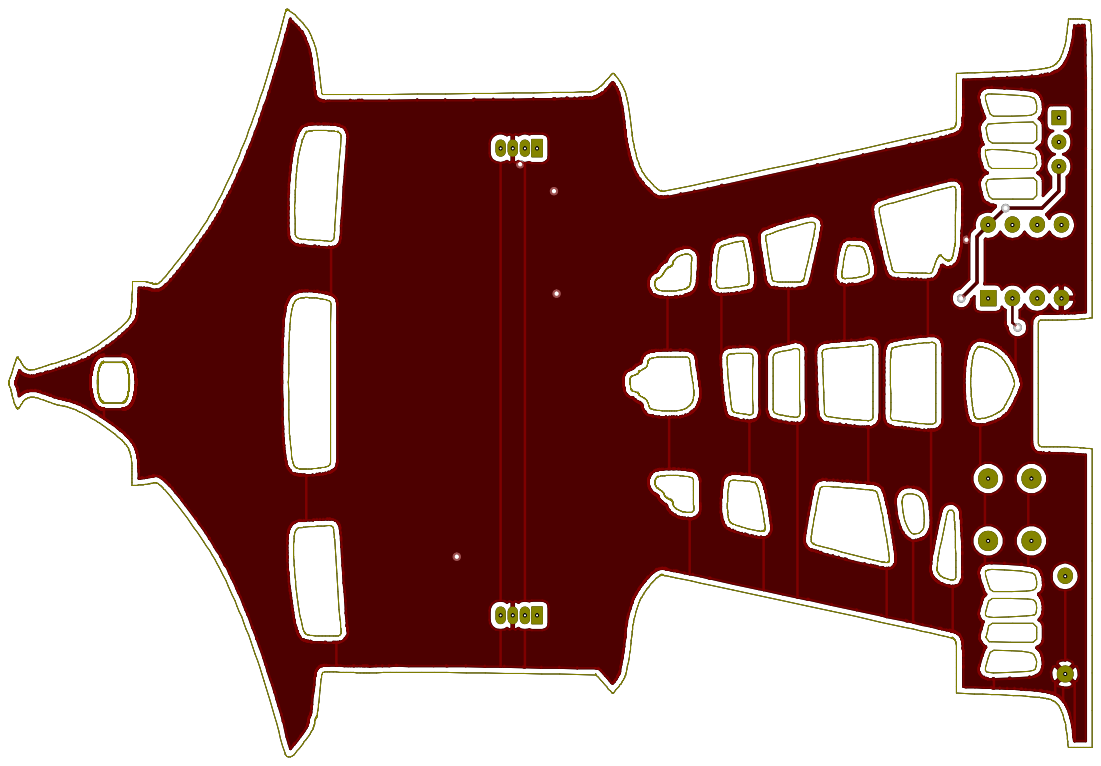
[picture p88: page 1]

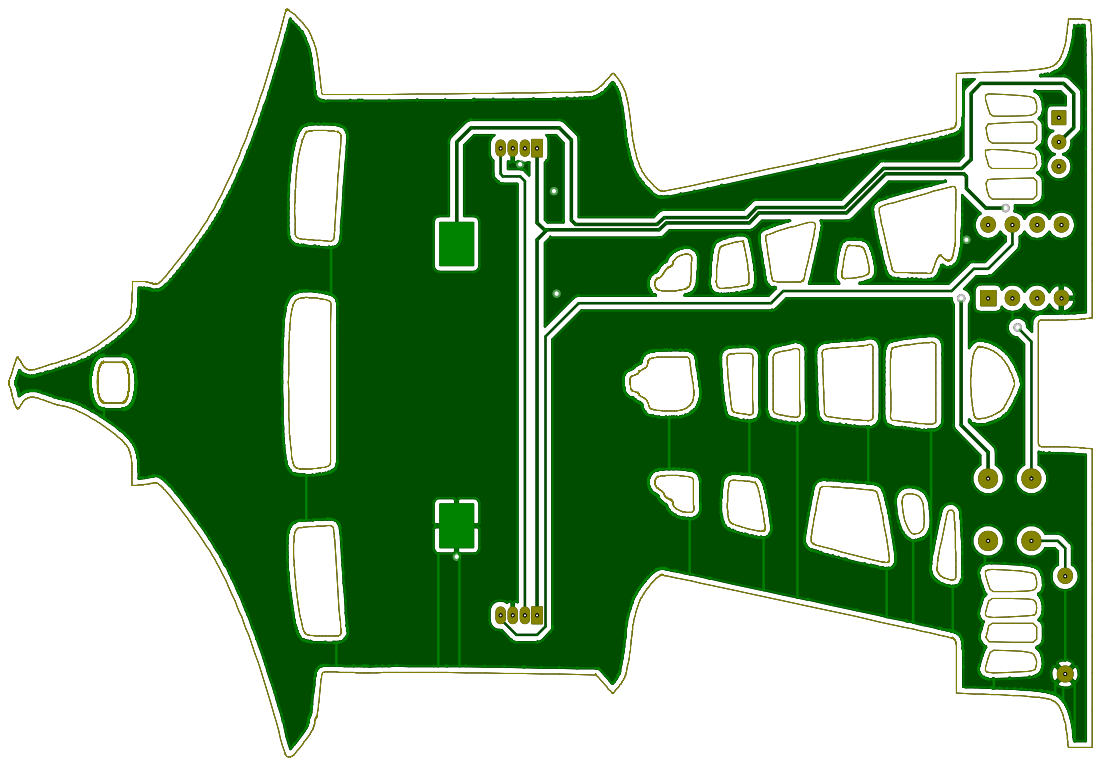
[picture p89: page 2]

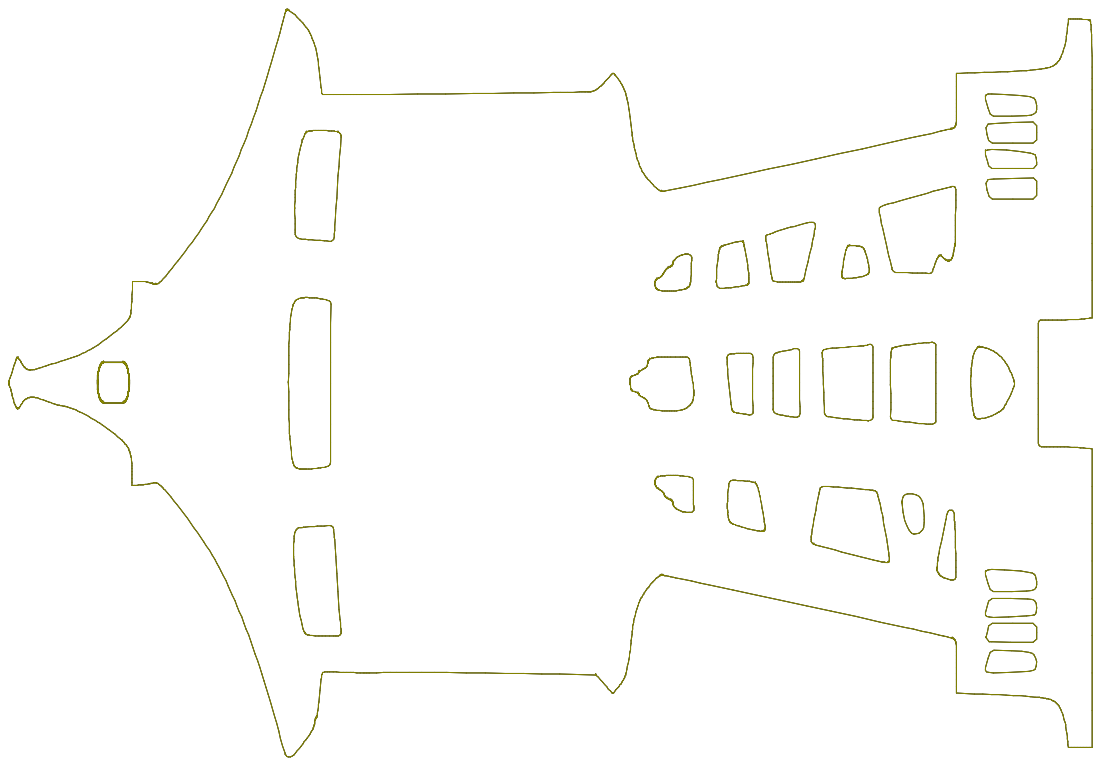
[picture p90: page 3]

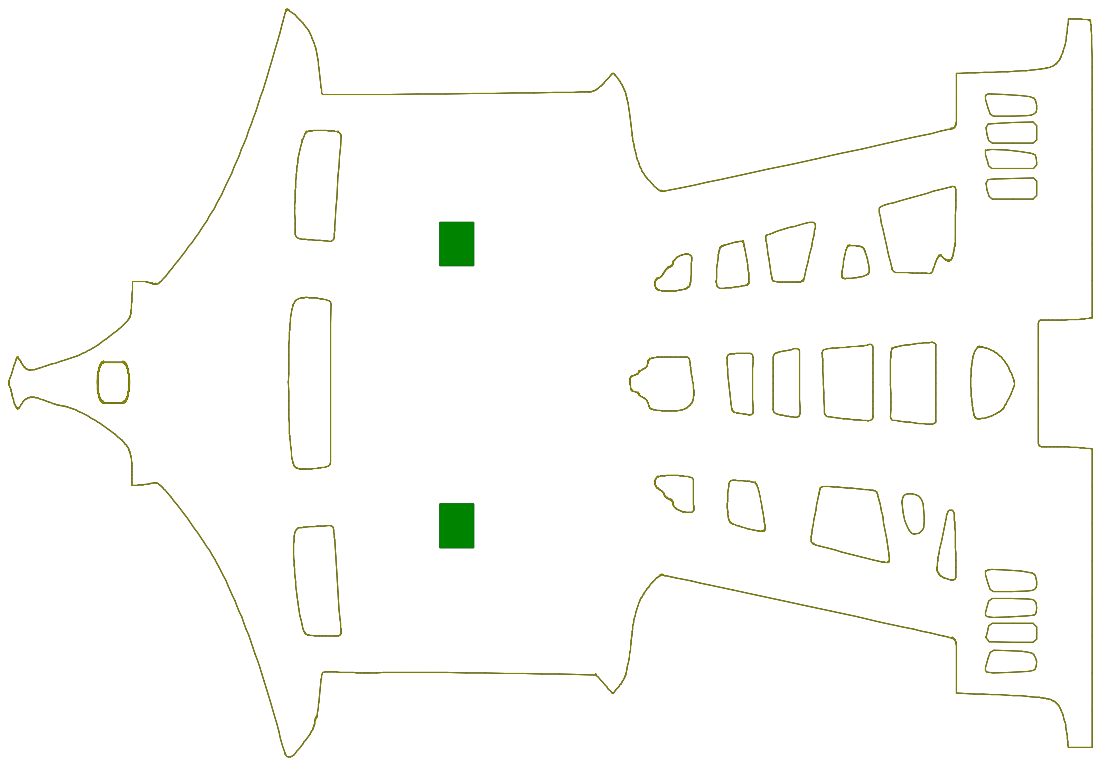
[picture p91: page 4]

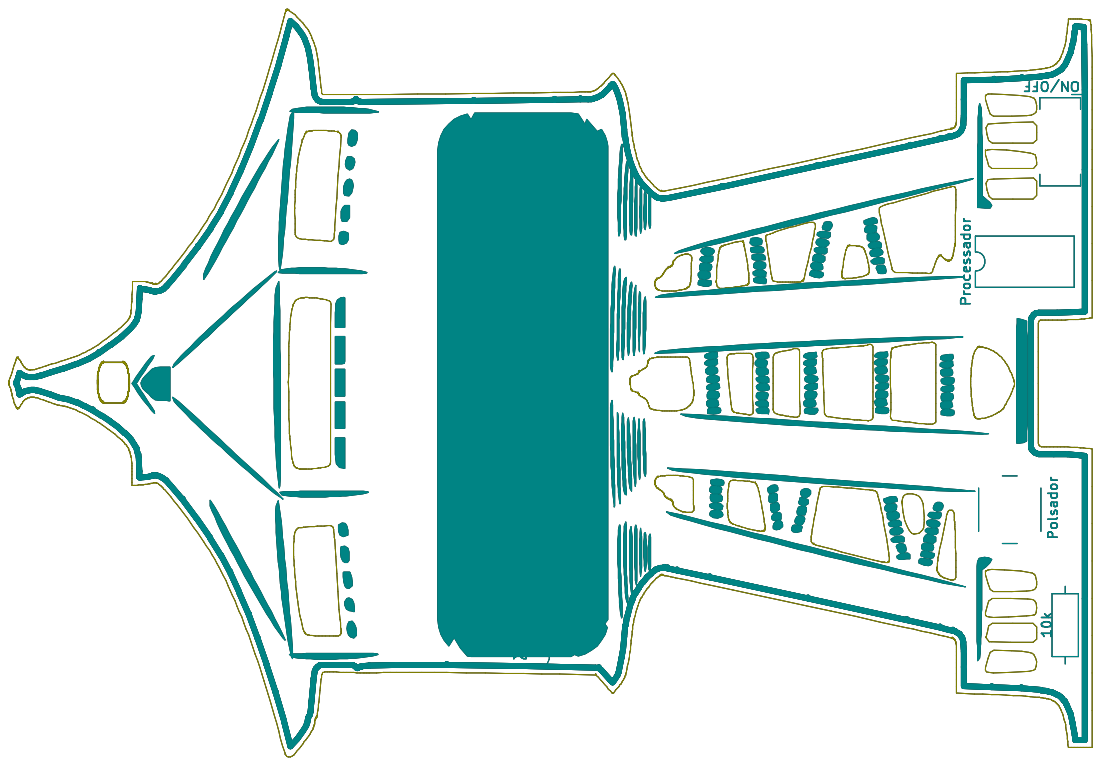
[picture p92: page 5]

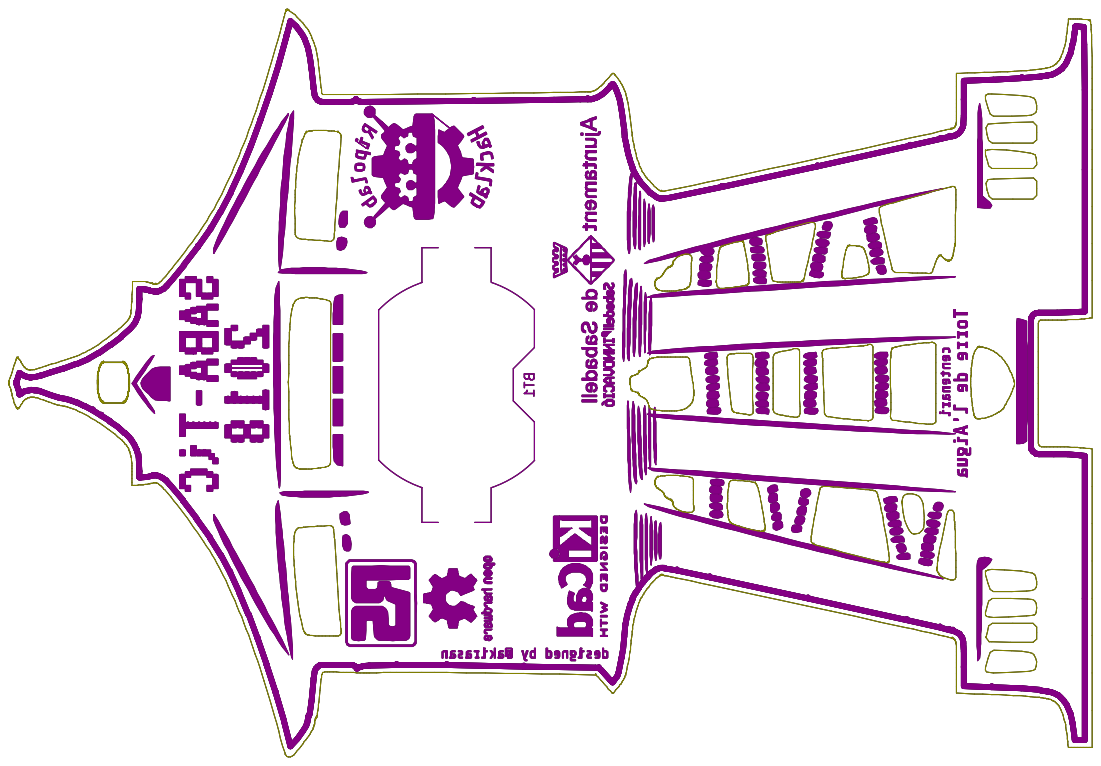
[picture p93: page 6]

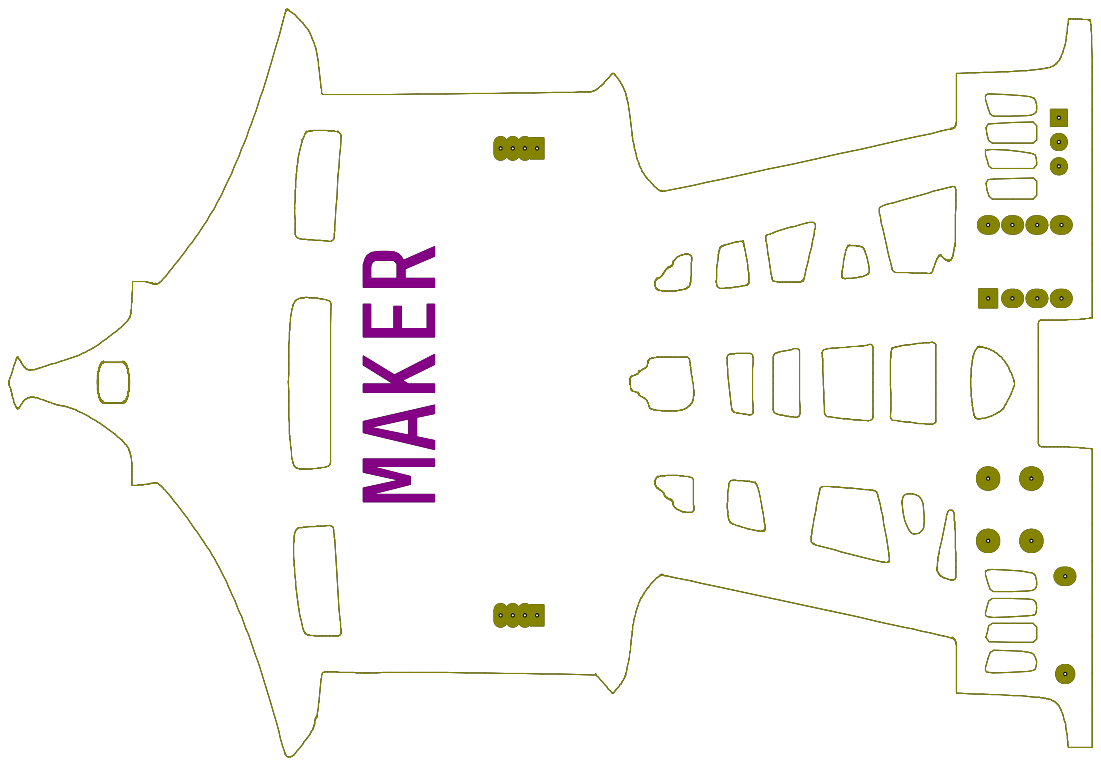
[picture p94: page 7]

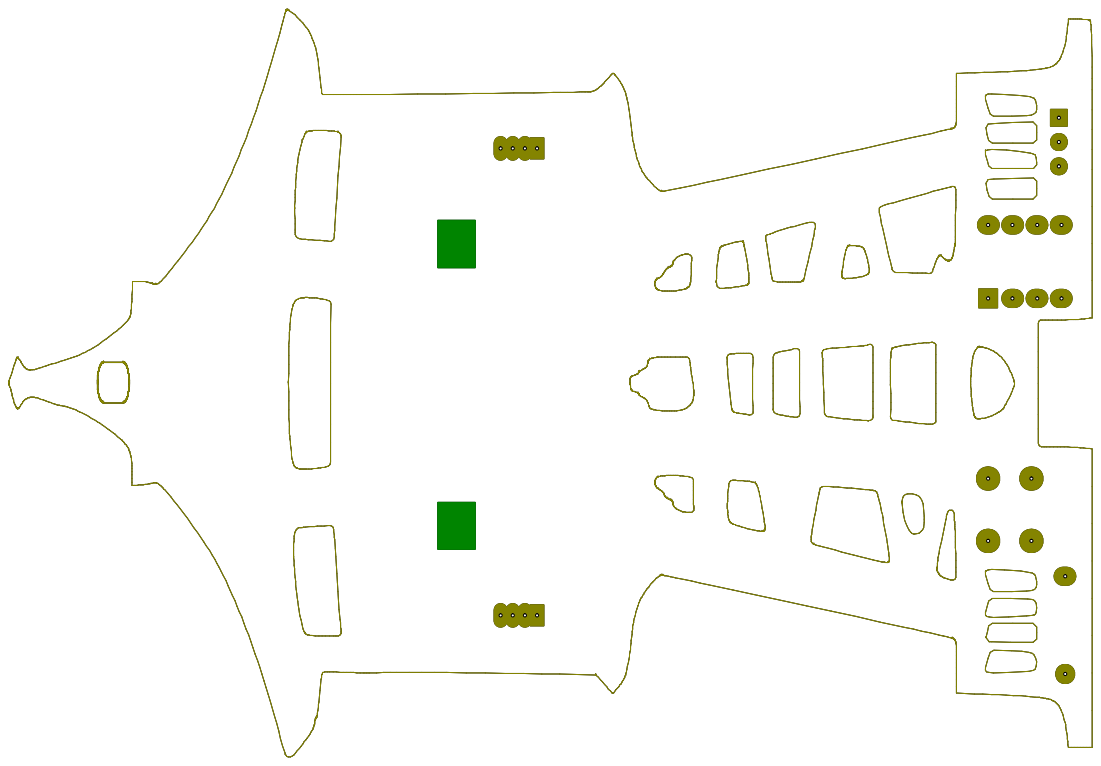
[picture p95: page 8]
