ripolab/Placas-PCB/Saba-TIC 2018/documentacion/all_PCB.pdf

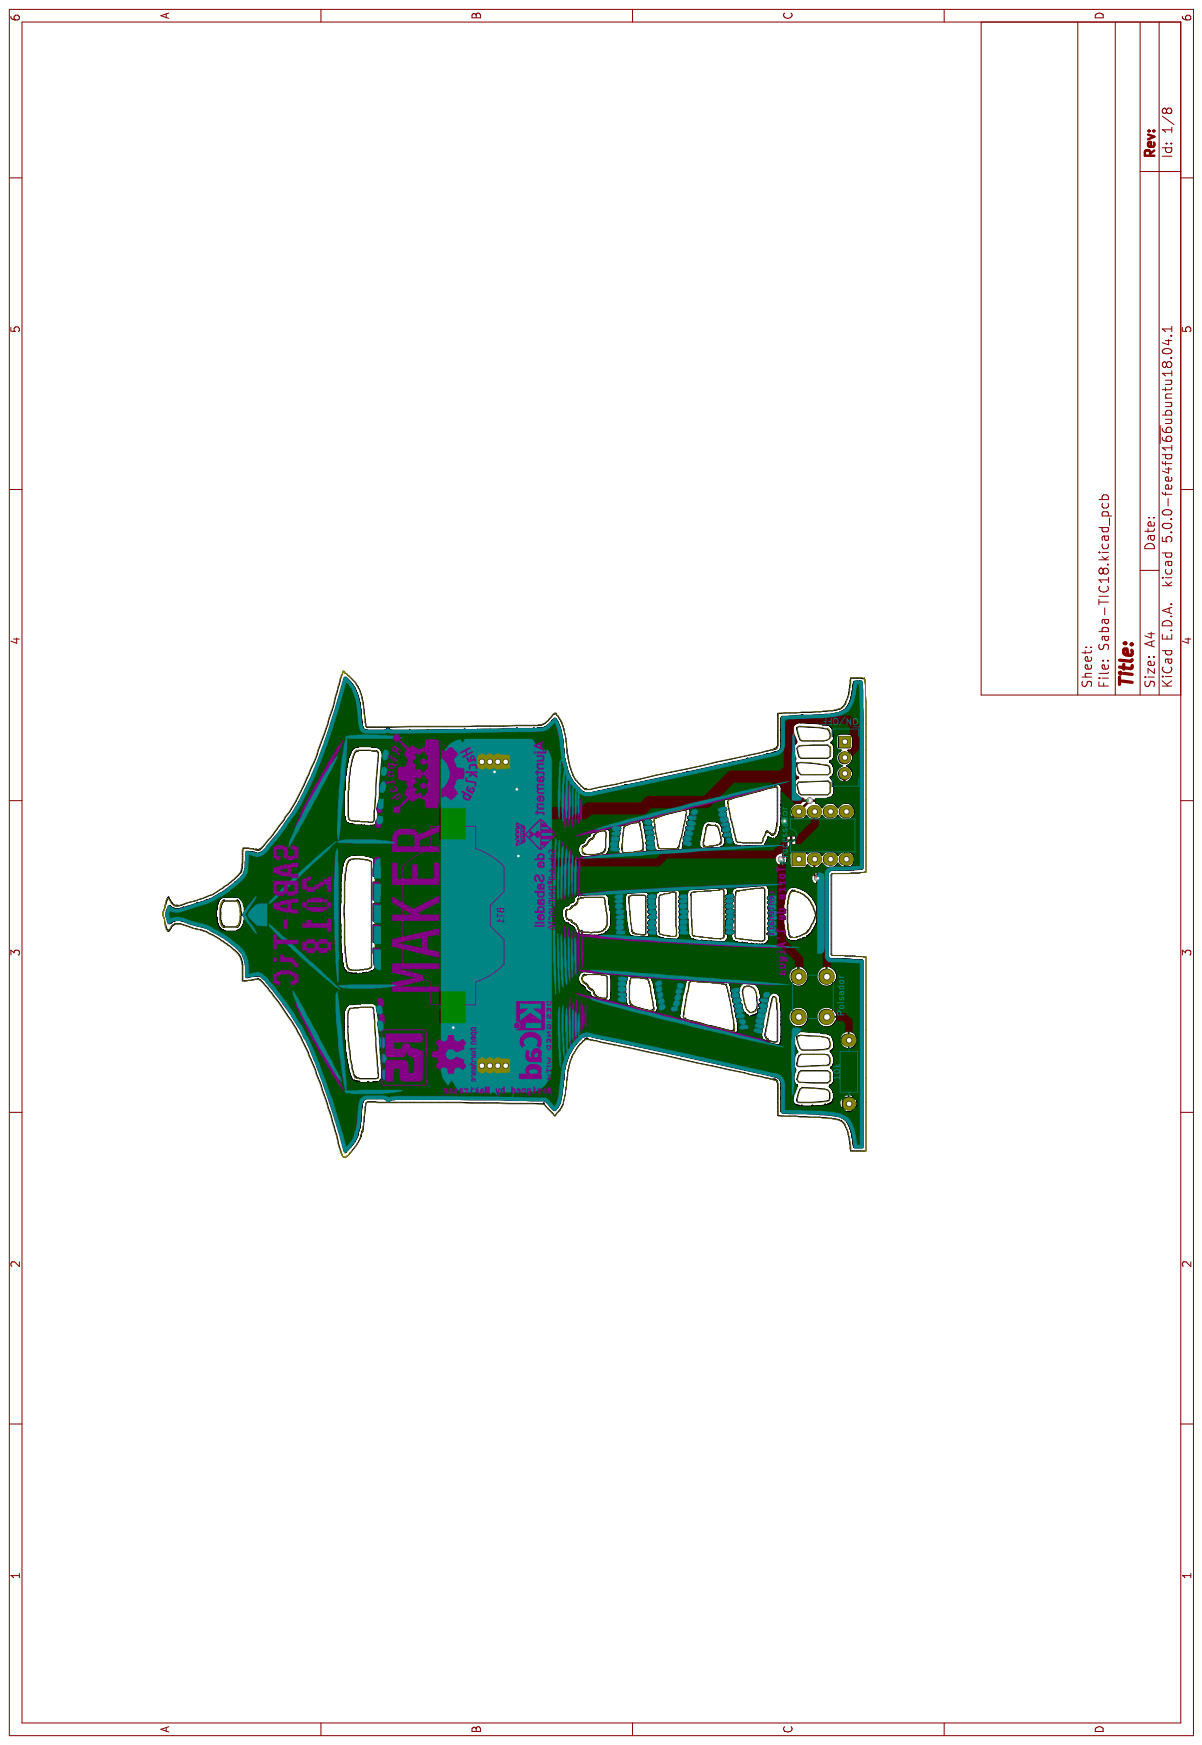
[picture p96: page 1]
