ripolab/Placas-PCB/Saba-TIC 2018/documentacion/back_PCB.pdf

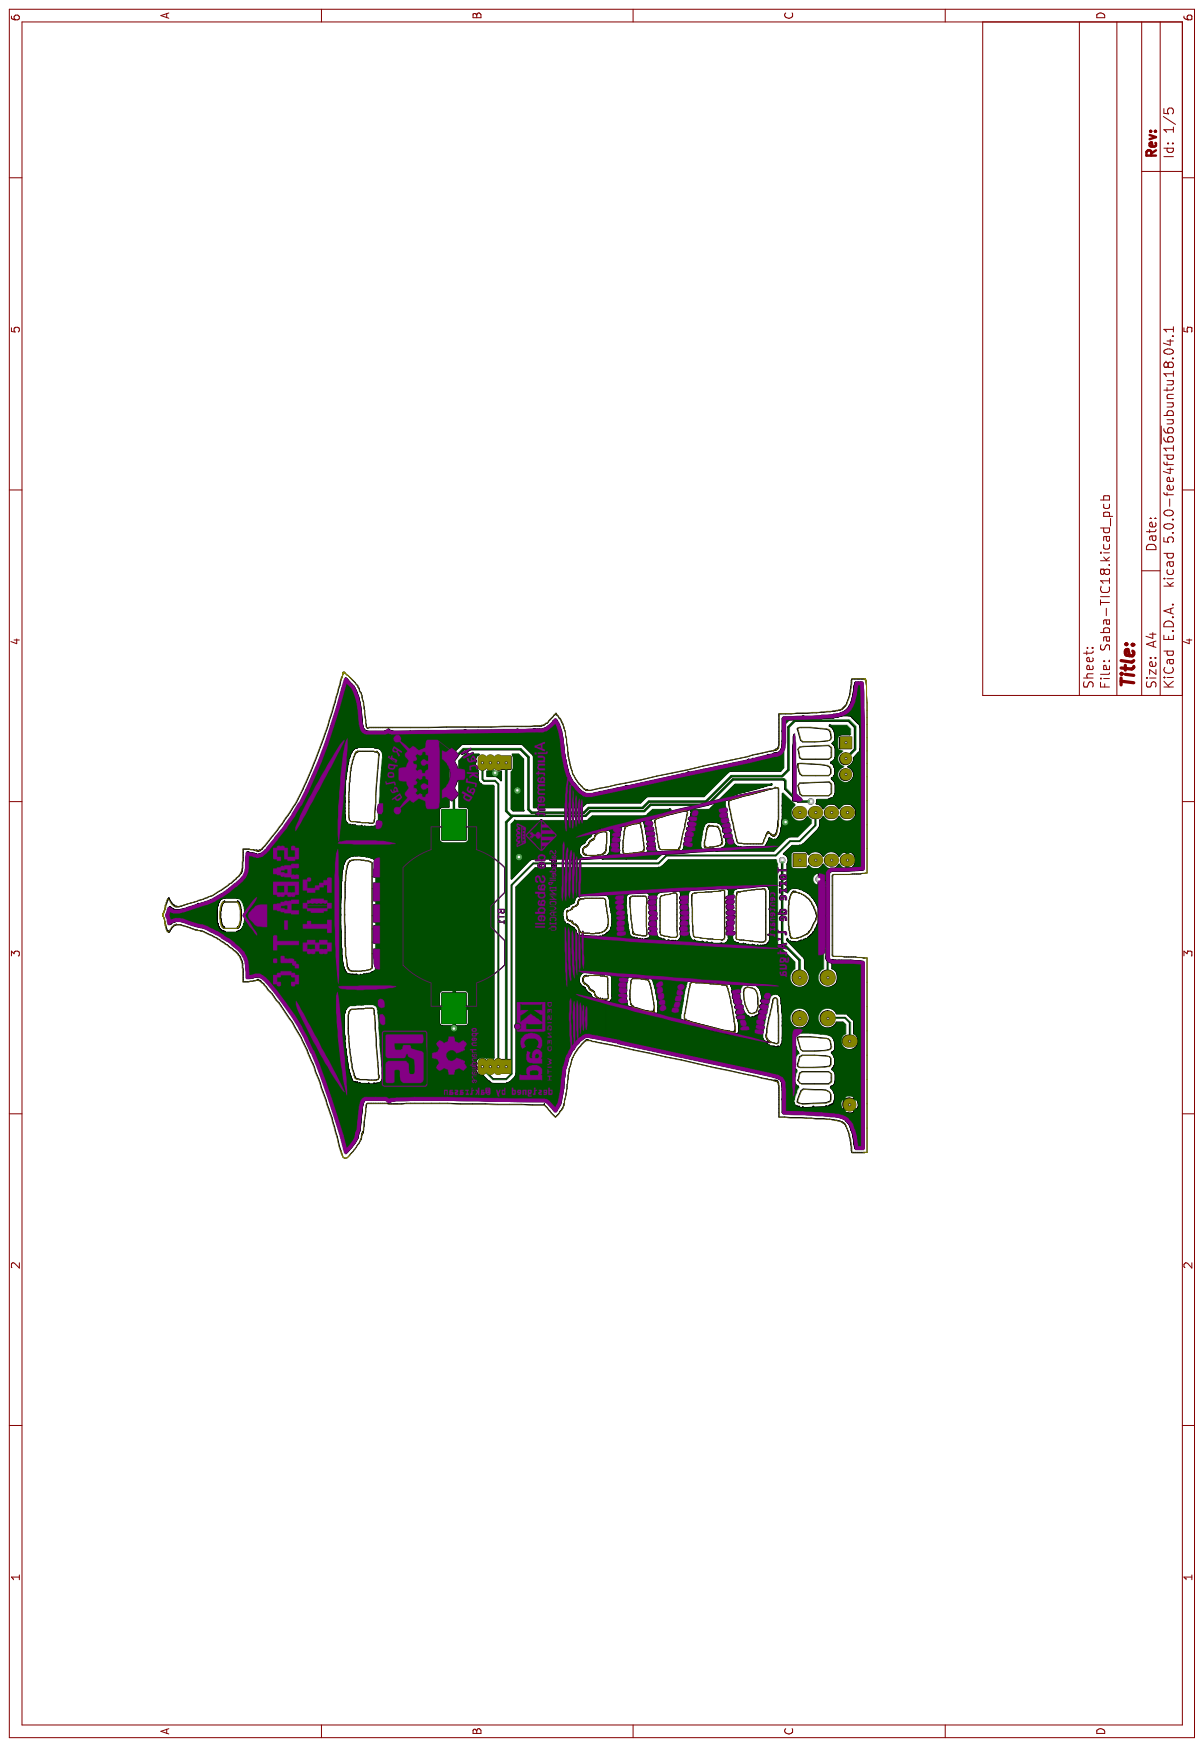
[picture p97: page 1]
