ripolab/Placas-PCB/Saba-TIC 2018/documentacion/front_PCB.pdf

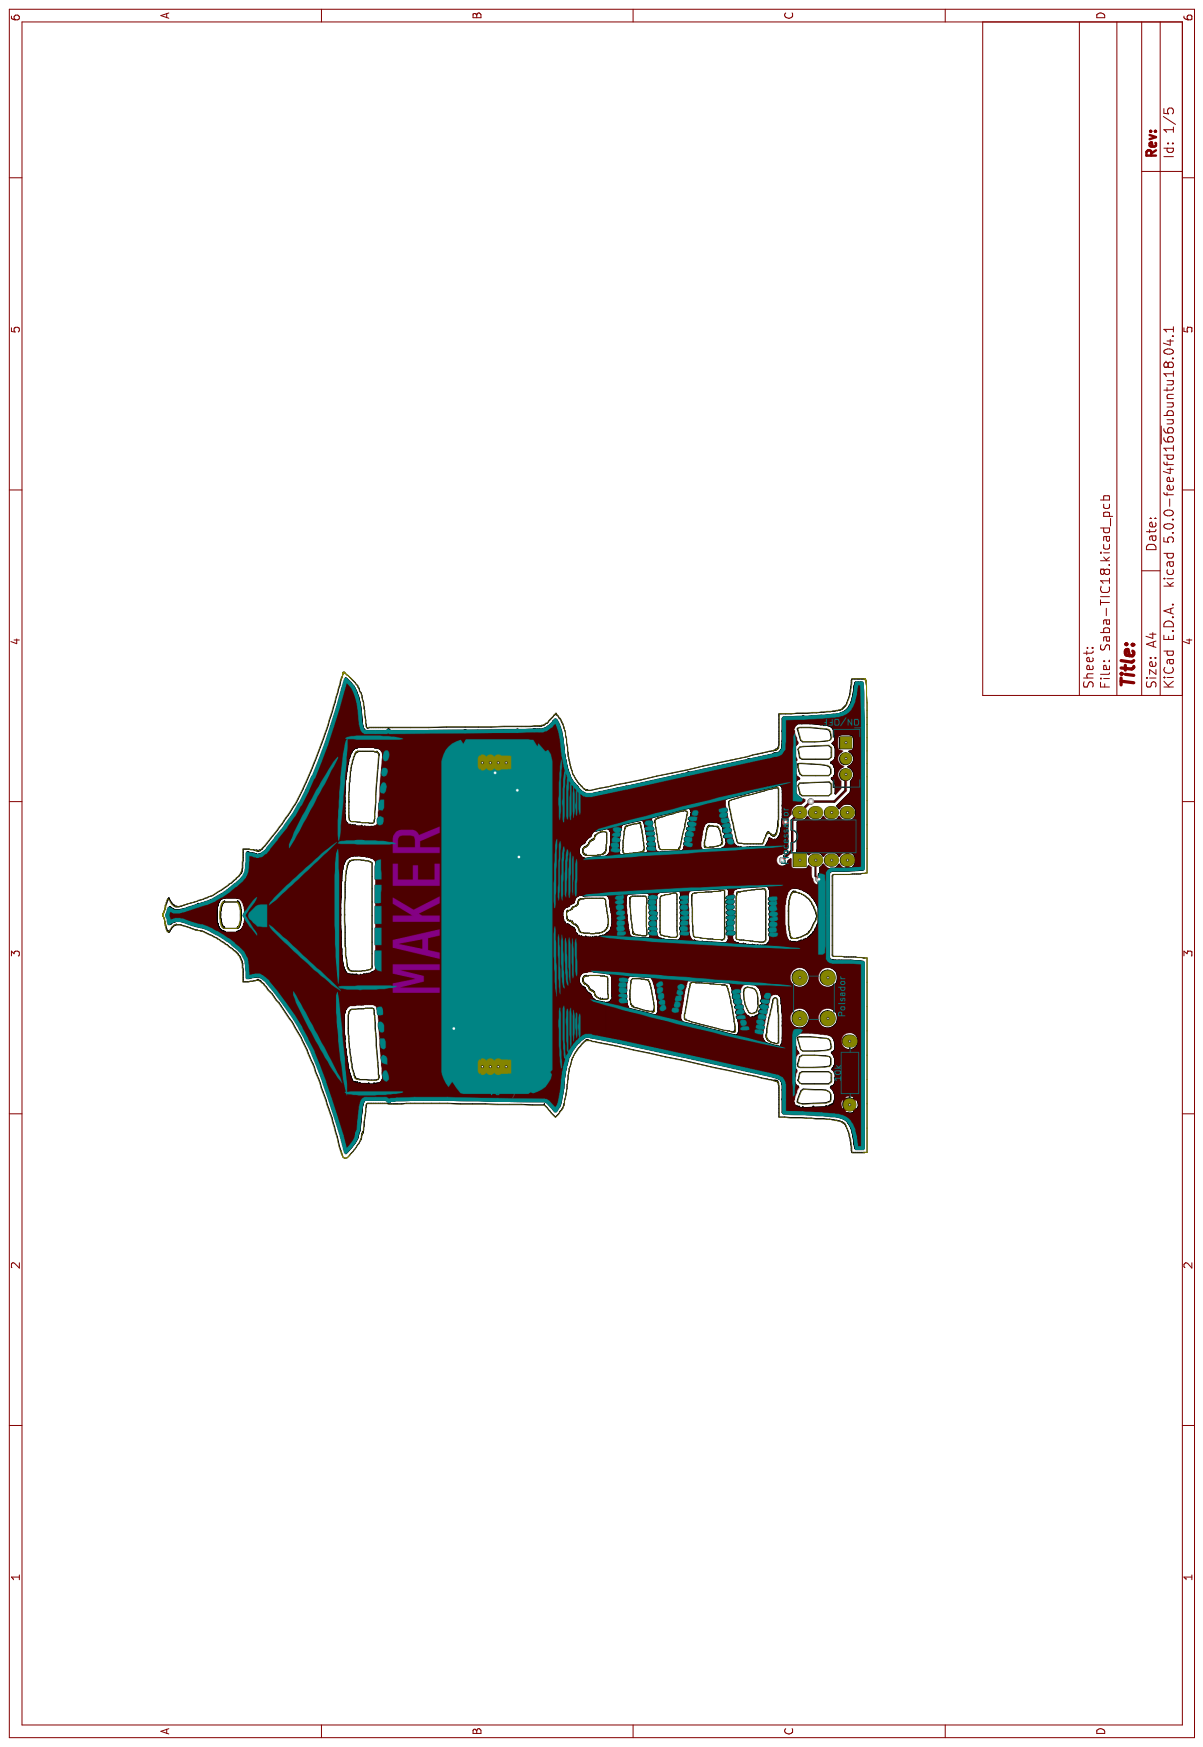
[picture p98: page 1]
