ripolab/Placas-PCB/(list of files, drawings)

Other design files:
ROBOTAC 19/Documentacion/cat/Esquema basico 1.fzz
Saba-TIC 2018/documentacion/Esquema basico 1.fzz
