ripolab/Placas-PCB/ROBOTAC 19/Documentacion/Ejemplo circuito simple RETO1/Ejemplo circuito simple.kicad_pcb

## KiCad design ROBOTAC 19/Documentacion/Ejemplo circuito simple RETO1/Ejemplo circuito simple.kicad_pcb (2018-09-09)

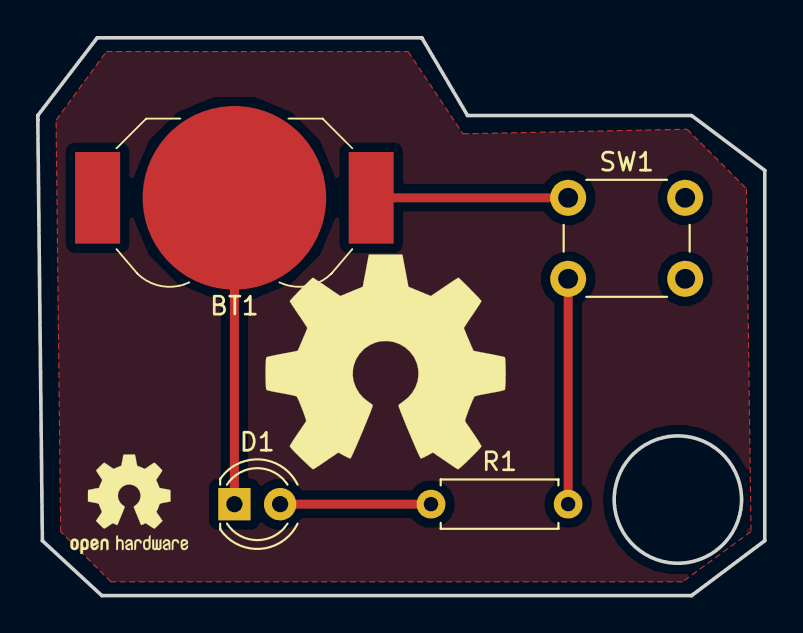
[picture p99: board Ejemplo circuito simple.kicad_pcb from above]

Board: 2 copper layers, 40.4 x 31.0 mm, 4 parts (0 on the bottom side), 4 nets.

Parts:
BT1: Battery_Cell; BatteryHolder_LINX_BAT-HLD-012-SMT
D1: LED; LED_D4.0mm
R1: R; R_Axial_DIN0207_L6.3mm_D2.5mm_P7.62mm_Horizontal
SW1: SW_Push; SW_PUSH_6mm_H5mm

Connections:
unnamed: BT1.1, SW1.1
unnamed: BT1.2, D1.1
unnamed: D1.2, R1.1
unnamed: R1.2, SW1.2
