ripolab/Placas-PCB/ripolab_pcb/ripolab_pcb.kicad_pcb

## KiCad design ripolab_pcb/ripolab_pcb.kicad_pcb (2018-05-23)

Schematic: ripolab_pcb.sch, Ripolab Hacklab Badged

Parts:
C1, C4: 47uF; C_0805_2012Metric_Pad1.15x1.50mm_HandSolder
C2: 100nF; C_0805_2012Metric_Pad1.15x1.50mm_HandSolder
C3: 10nF; C_0805_2012Metric_Pad1.15x1.50mm_HandSolder
D1: D_Schottky_ALT; D_SOD-123
GND_1: GND; TestPad
J1: Conn_01x02; Molex_PicoBlade_53261-0271_1x02_P1.25mm_Horizontal
LED1, LED2, LED3, LED4, LED5, LED6, LED7, LED8: WS2812B; LED_WS2812B-PLCC4
ON1: LED; LED_0805_2012Metric
PROG1: SW_Push; SW_SPST_TL3342
R1, R2, R3, R4, R5: 10K; R_0805_2012Metric
R6: 1K; R_0805_2012Metric
R7: 10K; R_0805_2012Metric_Pad1.15x1.50mm_HandSolder
RST1: SW_Push RESET; SW_SPST_TL3342
RST_1: TEST_1P; TestPad
RX_1: RX; TestPad
SW1: SPDT; SW_SPDT_PCM12
TX_1: TX; TestPad
U1: ESP-12E; ESP-12E_SMD
U2: SPX3819M5-L-3-3; SOT-23-5
VCC_1: TEST_VCC; TestPad

Connections:
+3,3V: C1.2, C3.1, C4.1, LED1.3, LED2.3, LED3.3, LED4.3, LED5.3, LED6.3, LED7.3, LED8.3, R1.1, R2.1, R4.1, R5.1, R6.1, U1.8, U2.5 (OUT), VCC_1.1
CH_PD: R1.2, U1.3
GND: C1.1, C2.2, C3.2, C4.2, GND_1.1, J1.2, LED1.1, LED2.1, LED3.1, LED4.1, LED5.1, LED6.1, LED7.1, LED8.1, ON1.1, PROG1.1, R3.1, RST1.1, U1.15, U2.2 (GND)
GPIO0: PROG1.2, R2.2, U1.18
GPIO2: R5.2, U1.17
GPIO4: LED1.2, U1.19
GPIO15: R3.2, U1.16
unnamed: C2.1, D1.1, R7.1, U2.1 (IN)
unnamed: LED1.4, LED2.2
unnamed: LED2.4, LED3.2
unnamed: LED3.4, LED4.2
unnamed: LED4.4, LED5.2
unnamed: LED5.4, LED6.2
unnamed: LED6.4, LED7.2
unnamed: LED7.4, LED8.2
unnamed: ON1.2, R6.2
unnamed: R7.2, U2.3 (EN)
Reset: R4.2, RST1.2, RST_1.1, U1.1
Rx: RX_1.1, U1.21
Tx: TX_1.1, U1.22
VBAT: J1.1, SW1.2
VBAT_SW: D1.2, SW1.1

Notes on the sheet:
Módulo ESP8266
Neopixels WS2812B
Alimentación
Configuracion + Push B

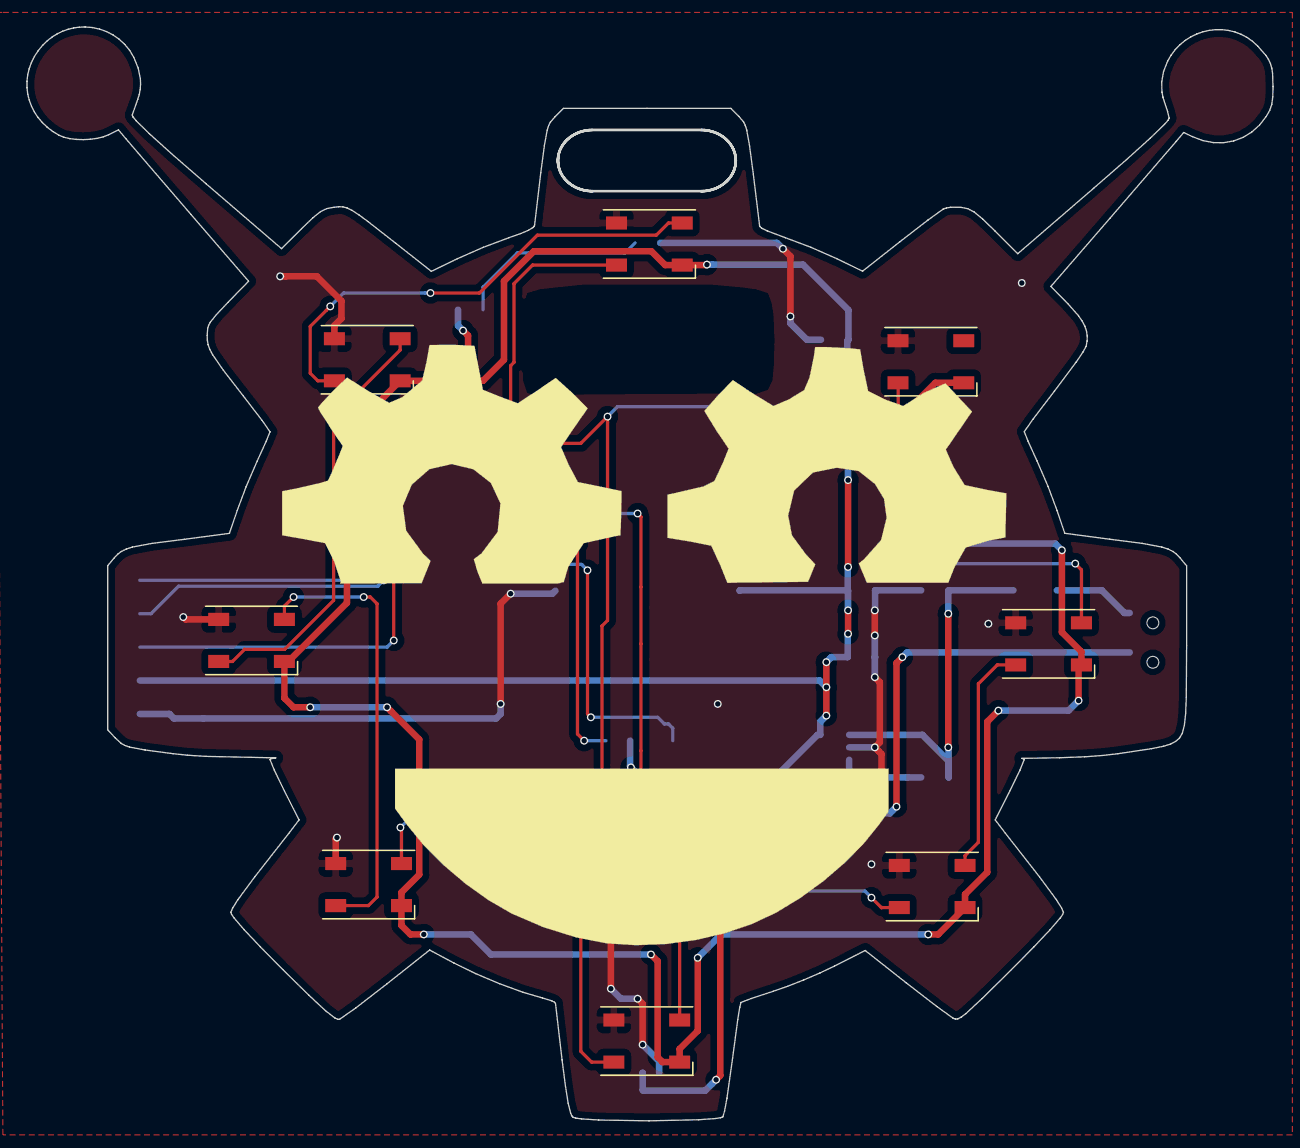
[picture p100: board ripolab_pcb.kicad_pcb from above]

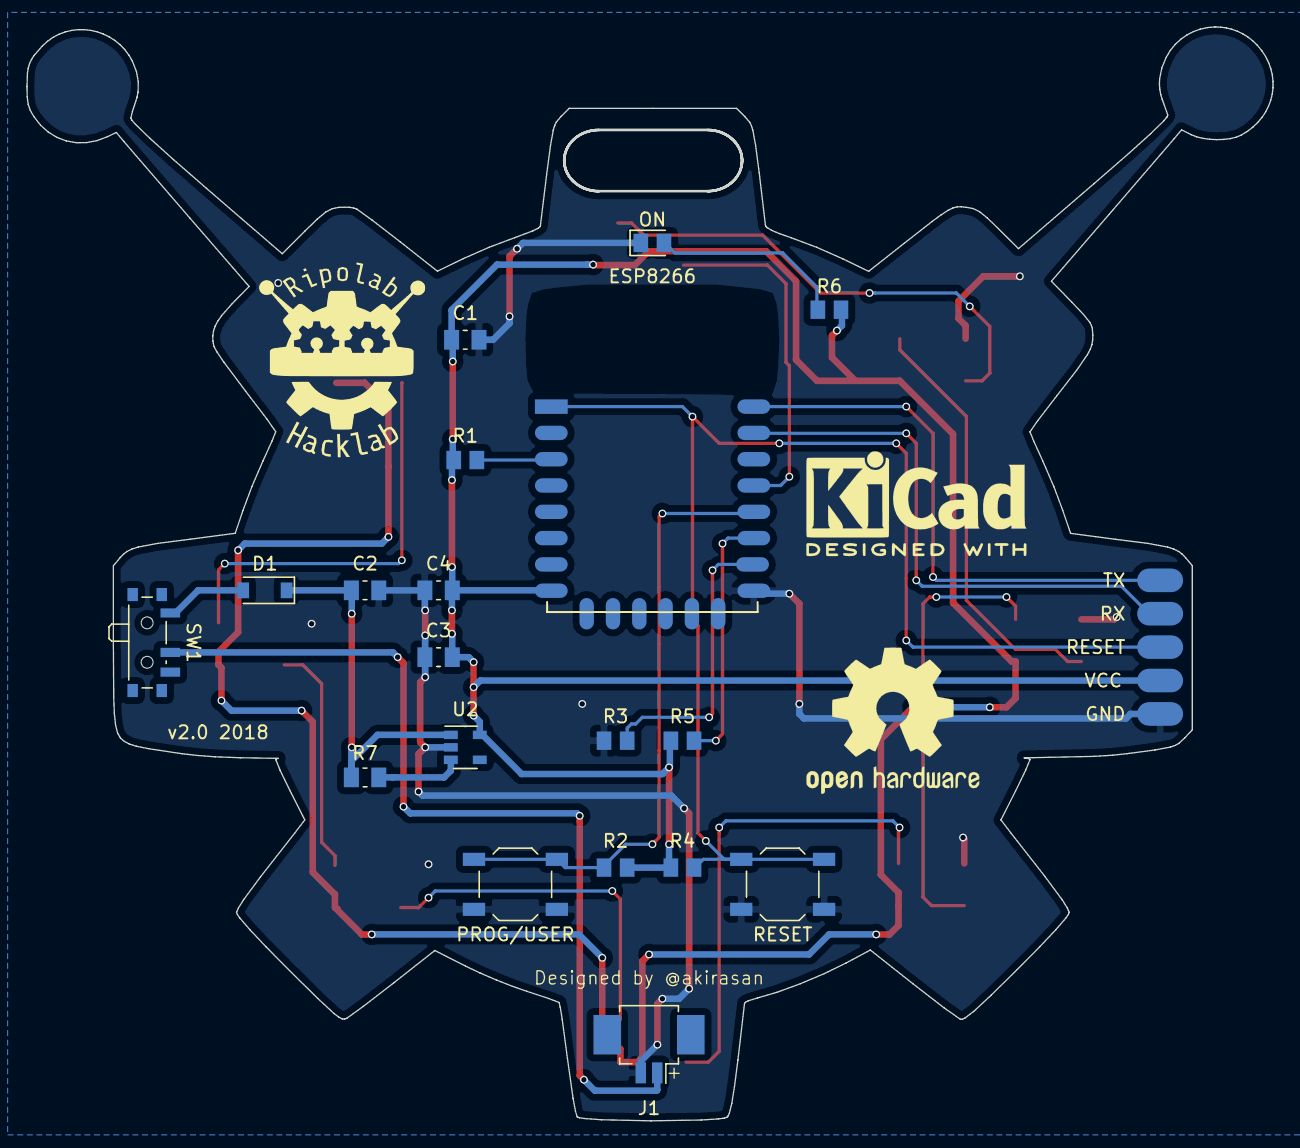
[picture p101: board ripolab_pcb.kicad_pcb from below]

Board: 2 copper layers, 94.7 x 83.2 mm, 34 parts (25 on the bottom side), 22 nets.

Other parts of the board:
svg2mod: G***; logo_pcb_cara.pretty
svg2mod#2: G***; logo_ripolab_12x14mm
