ripolab/Placas-PCB/ripolab_pcb_kids/ripolab_pcb_kids.kicad_pcb

## KiCad design ripolab_pcb_kids/ripolab_pcb_kids.kicad_pcb (2018-04-04)

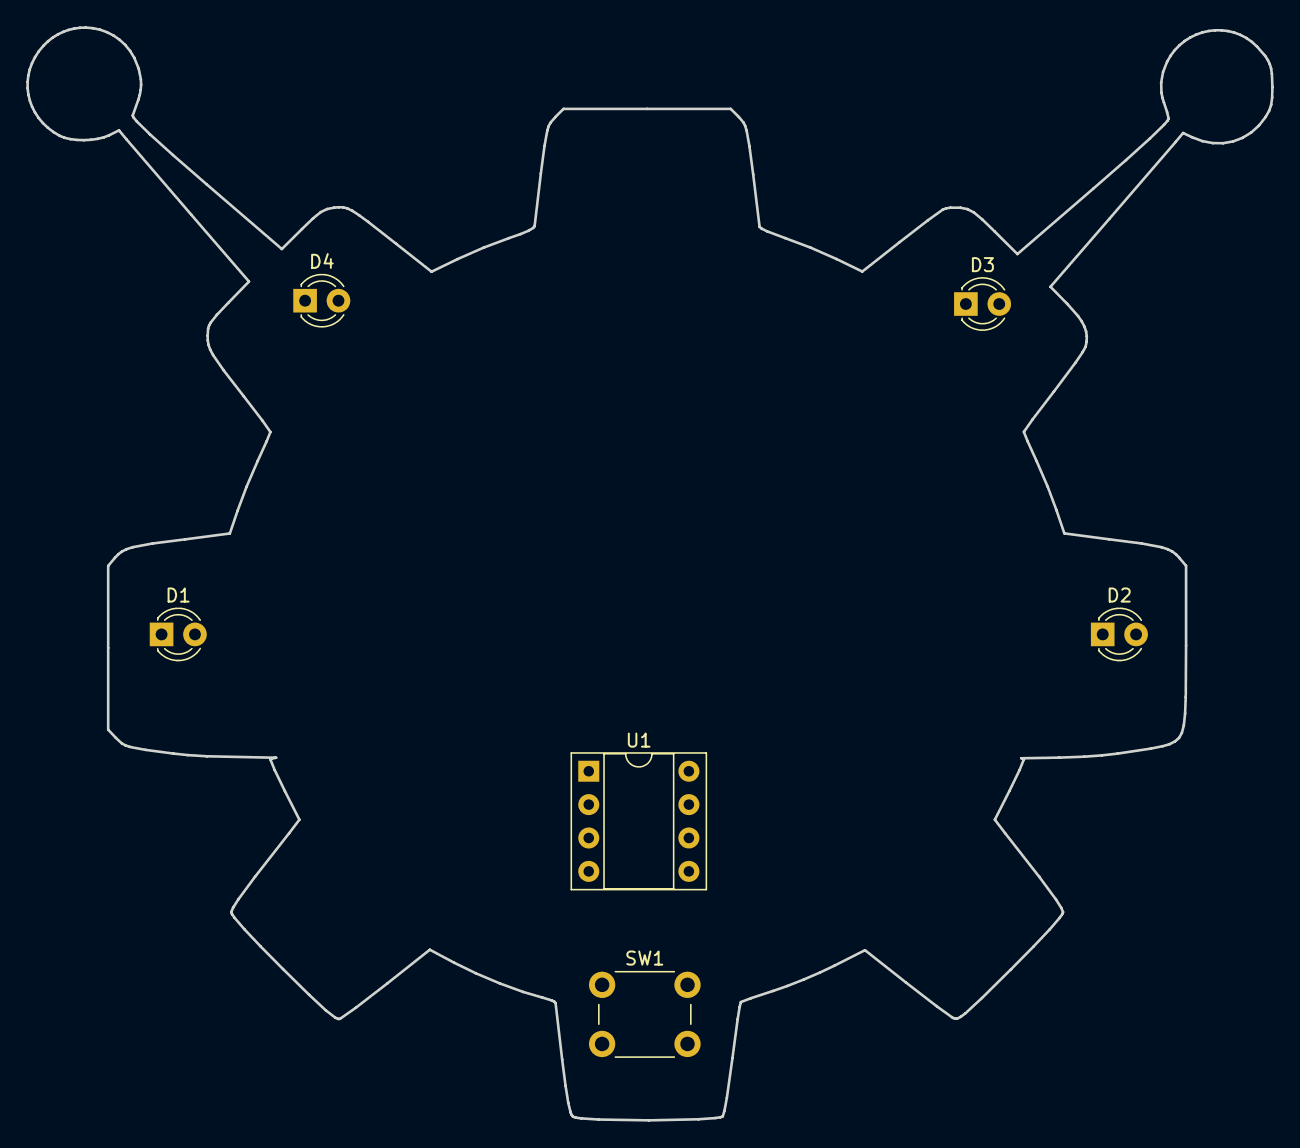
[picture p102: board ripolab_pcb_kids.kicad_pcb from above]

Board: 2 copper layers, 94.7 x 83.2 mm, 6 parts (0 on the bottom side), 6 nets, no tracks yet.

Parts:
D1, D2, D3, D4: LED; LED_D3.0mm
SW1: SW_DIP_x02; SW_PUSH_6mm
U1: LM555; DIP-8_W7.62mm_Socket

Connections:
GND: D1.1, U1.1
unnamed: D1.2, D2.1
unnamed: D2.2, D3.1
unnamed: D3.2, D4.1
unnamed: D4.2, U1.5
unnamed: SW1.2, U1.8
