ripolab/Placas-PCB/(commit log)

2018-02-21 Primera aportacion
    [Tactile_SMD_5x5mm.SLDPRT, Tactile_SMD_5x5mm.STEP, ripolab_pcb.kicad_pcb, ripolab_pcb.sch, ripolab_pcb_corte.dxf, ripolab_pcb_kids.kicad_pcb, ripolab_pcb_kids.sch, ripolab_protroboard.kicad_pcb]
2018-04-04 badge ripolab v1
    [AB2_PB_MOM_5.2MM_SMD.stl, WS2812_RGB_LED_updated.stp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]
2018-05-01 version 2.0 (corrección v1.0)
    [ripolab_pcb.kicad_pcb, ripolab_pcb.sch]
2018-05-23 v2 update + BOM
    [ripolab_pcb-B.Cu.gbr, ripolab_pcb-B.Mask.gbr, ripolab_pcb-B.SilkS.gbr, ripolab_pcb-Edge.Cuts.gbr, ripolab_pcb-F.Cu.gbr, ripolab_pcb-F.Mask.gbr, ripolab_pcb-F.SilkS.gbr, ripolab_pcb-NPTH.drl]
2018-08-13 PCB Saba-TIC 2018
    PCB de la badge de Saba-TIC 2018 para el taller de soldadura familiar
    [Esquema basico 1.fzz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]
2018-09-09 Actualización final tras taller
    Actualización final tras el taller, incluyendo documentación y piezas 3D utilizadas para la mesa de trabajo.
    [Ejemplo circuito simple.kicad_pcb, Ejemplo circuito simple.sch, Esquema basico 1.fzz, bobina_estaño.stl, soporte_3hands_v4.stl, soporte_soldador_v3.stl]
2019-04-06 RoboTAC 2019
    [CR2032 holder.step, Vertical slide switch SS-12D00G3 High Knob 3mm SPDT v2.step, corte exterior.dxf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]
